WATonomous/interfacing-mono/DBW-boards/readMe.md

# DBW Boards
- This folder contaisn schematics, pcb layouts, as well as component lists + where to order for the DBW boards for Watonomous's VP division.
- There are 4 boards to be assembled/fabricated off of these. 
##Boards
- Control (Brake)
- Can Gateway
- 2 Sensor boards, one for throttle and one for steering

### Each board is a Kicad project, simply download this repo and open them in Kicad.
