WATonomous/interfacing-mono/oscc-joystick-commander/oscc/hardware/3d_models/brake_enclosure/brake_assembly.SLDASM

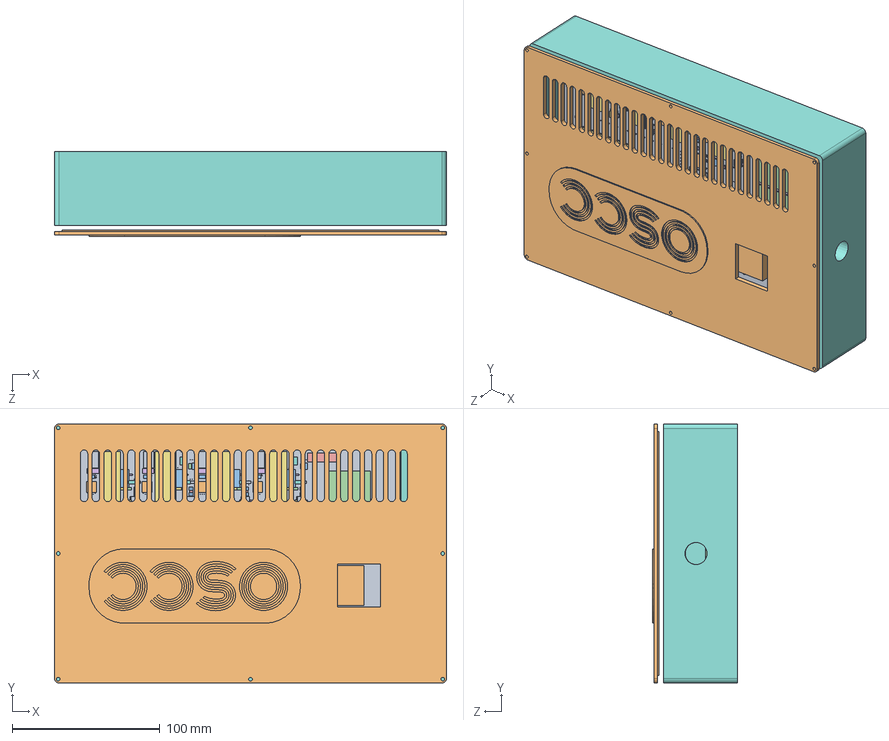
[picture p2: CAD file, 2024-09-14]
oscc-joystick-commander/oscc/hardware/3d_models/brake_enclosure/brake_assembly.SLDASM
265.0 x 175.0 x 57.4 mm
polysync_braking
1X08_1X08 x 5
C1206_1U x 12
C0805_0_1U x 12
C0402_100P x 8
C0402__1U x 18
CP1206_33U
C0402_22P x 2
PHOENIX_2_45_CON23_5MM x 9
PHOENIX_3_45_CON3 x 2
PHOENIX_2_10_16MM_CON210_16MM
1932575_CON1 x 2
PHOENIX_5_45_CON5
SMA_DIODES_SMA x 8
SOD123_DIODES_SOD123 x 8
LED0603_D17_LED0603
LED0603_D18_LED0603
LED0603_D19_LED0603
LED0603_D20_LED0603
LED0603_D21_LED0603
FUSE_ATO_20A x 2
FUSE_ATO_40A
HEATSINKTO263_HEATSINKTO263 x 8
1X10_1X10
JP1_JP2_JP1
SRP7050_2_2U x 8
TO2633_NFETTO263 x 8
SOT233_Q9_SOT233
EMT3F_RE1C002UN
R0402_10K x 9
R0805_100 x 8
R1206__02 x 8
R0805_0 x 8
R0402_100K x 24
R0402_1K x 45
R0402__3
R0402_120
R0402_47K
R0402_0 x 5
R0402_DNP x 5
KEMET_EE2_RELAY_DPDT
VCF4_RELAY_RELAY_BOM
VCF4SOCKET_RELAY_VF4
TP_4545_TP1_TP_4545
TP_4545_TP2_TP_4545
TP_4545_TP3_TP_4545
POLYSYNC_BRAKE_TOP_U_8_POLYSYNC_BRAKE_TOP
SOIC8_UCC27524 x 4
SOT235_OPA170 x 8
TO263_TL750M
SOIC86_0_MCP2551
SOIC18_MCP2515
HC49UP_16MHZ
2X18_2X18
ArduinoMega
brake_housing
brake_cable_clamp
brake_house_lid
