WATonomous/interfacing-mono/oscc-joystick-commander/oscc/hardware/3d_models/dash_enclosure/STC_assembly.SLDASM

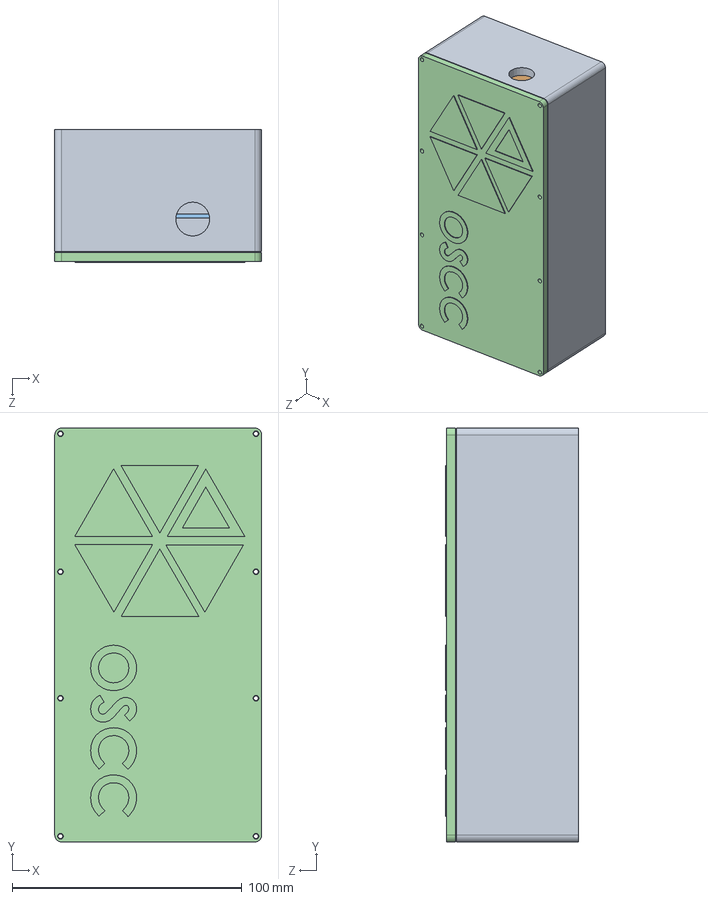
[picture p3: CAD file, 2024-09-14]
oscc-joystick-commander/oscc/hardware/3d_models/dash_enclosure/STC_assembly.SLDASM
90.2 x 180.0 x 57.9 mm
STC_housing
ArduinoUnoMockup x 3
CANShieldMockup x 2
STC_lid
