WATonomous/interfacing-mono/oscc-joystick-commander/oscc/hardware/3d_models/kia_soul/actuator_bracket_assembly.SLDASM

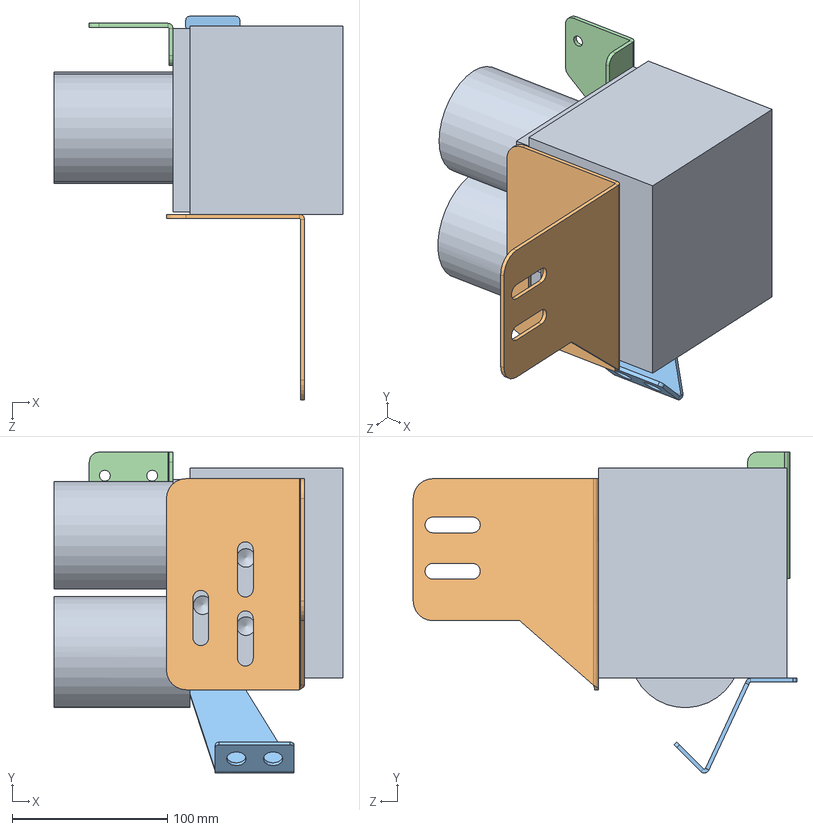
[picture p4: CAD file, 2024-09-14]
oscc-joystick-commander/oscc/hardware/3d_models/kia_soul/actuator_bracket_assembly.SLDASM
185.7 x 206.6 x 246.8 mm
actuator_mockup
side_bracket
bottom_bracket
reservoir_bracket
