WATonomous/interfacing-mono/oscc-joystick-commander/oscc/hardware/3d_models/brake_enclosure/actuator_control_board_enclosure_assembly.SLDASM

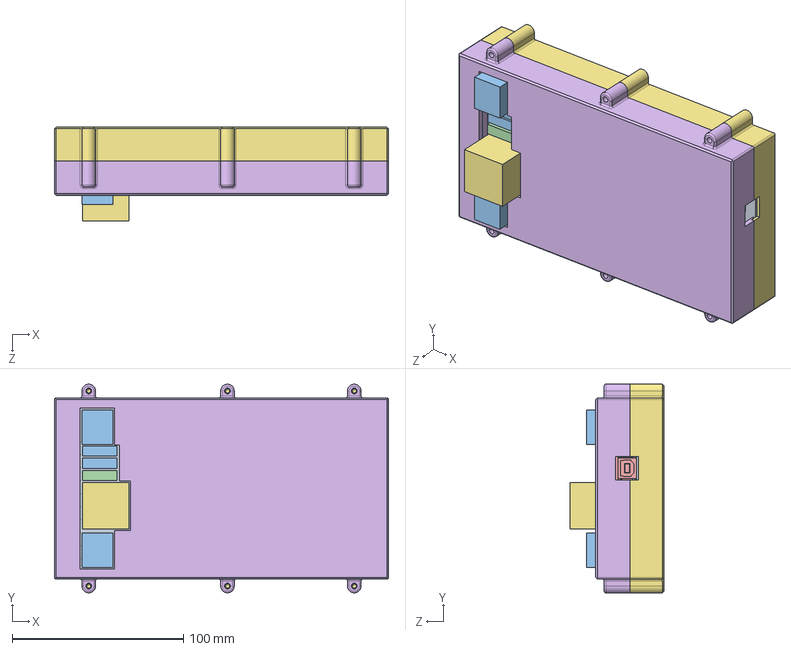
[picture p5: CAD file, 2024-09-14]
oscc-joystick-commander/oscc/hardware/3d_models/brake_enclosure/actuator_control_board_enclosure_assembly.SLDASM
195.2 x 122.0 x 55.0 mm
actuator_control_board_100
1X08_1X08 x 5
C1206_1U x 12
C0805_0_1U x 12
C0402_100P x 8
C0402__1U x 18
CP1206_33U
C0402_22P x 2
PHOENIX_2_45_CON23_5MM x 10
PHOENIX_3_45_CON3 x 2
PHOENIX_2_10_16MM_CON210_16MM x 2
PHOENIX_5_45_CON5
SMA_DIODES_SMA x 8
SOD123_DIODES_SOD123 x 8
LED0603_D17_LED0603
LED0603_GREEN x 2
LED0603_RED
LED0603_BLUE
FUSE_ATO_20A x 2
FUSE_ATO_40A
1X10_1X10
JP1_JP2_JP1
SRP7050_2_2U x 8
SON8DQJ_NFETTO263NEXFET x 8
SOT233_Q9_SOT233
EMT3F_RE1C002UN
R0402_10K x 9
R0805_100 x 8
R1206__02 x 8
R0805_0 x 8
R0402_100K x 24
R0402_1K x 45
R0402__3
R0402_120
R0402_47K
R0402_0 x 5
R0402_DNP x 5
KEMET_EE2_RELAY_DPDT
VCF4_RELAY_RELAY_BOM
HEATSINK_2X_75_U_3_HEATSINK_2X_75
HEATSINK_2X_75_U_7_HEATSINK_2X_75
HEATSINK_2X_75_U_9_HEATSINK_2X_75
HEATSINK_2X_75_U_10_HEATSINK_2X_75
OSCC_LOGO_U_11_OSCC_LOGO
POLYSYNC_U_13_POLYSYNC
SOIC8_UCC27524 x 4
SOT235_OPA170 x 8
TO263_TL750M
SOIC86_0_MCP2551
SOIC18_MCP2515
HC49UP_16MHZ
2X18_2X18
ArduinoMega
actuator_control_board_enclosure_top
actuator_control_board_enclosure_bottom
