WATonomous/interfacing-mono/oscc-joystick-commander/oscc/hardware/3d_models/dash_enclosure/STC_housing.sldprt

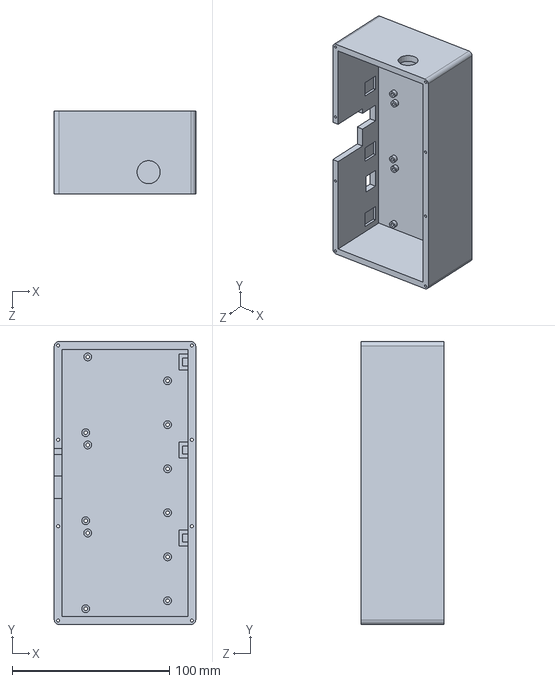
[picture p6: CAD file, 2024-09-14]
oscc-joystick-commander/oscc/hardware/3d_models/dash_enclosure/STC_housing.sldprt
90.0 x 180.0 x 53.0 mm
