WATonomous/interfacing-mono/oscc-joystick-commander/oscc/hardware/3d_models/estop_cupholder/EStopHousing.SLDPRT

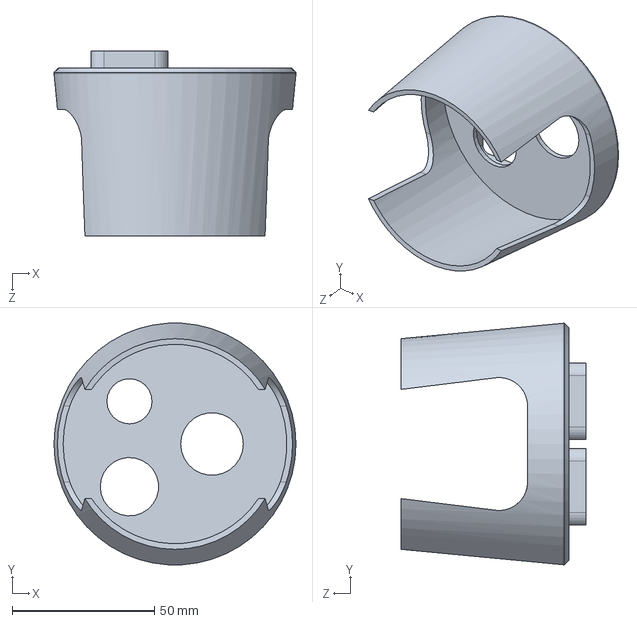
[picture p7: CAD file, 2024-09-14]
oscc-joystick-commander/oscc/hardware/3d_models/estop_cupholder/EStopHousing.SLDPRT
85.0 x 84.8 x 65.0 mm
