WATonomous/interfacing-mono/oscc-joystick-commander/oscc/hardware/3d_models/kia_soul/side_bracket.SLDPRT

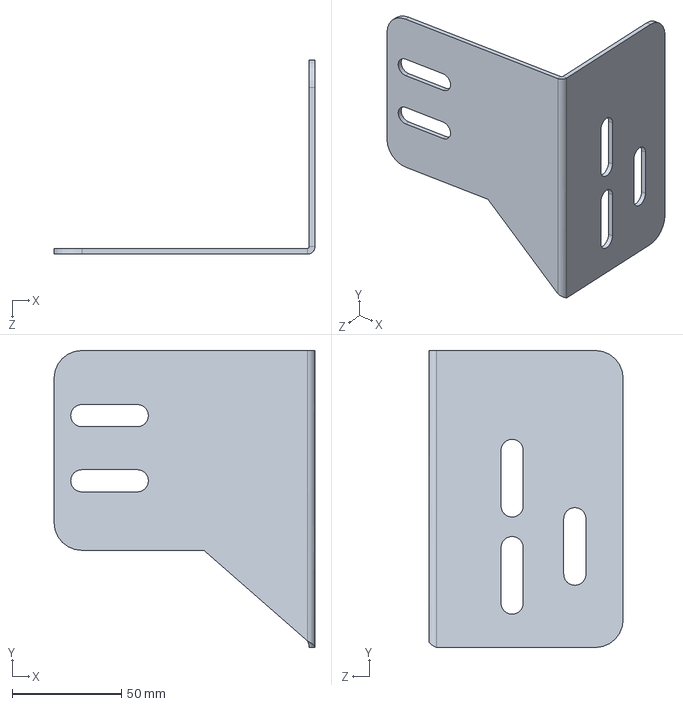
[picture p8: CAD file, 2024-09-14]
oscc-joystick-commander/oscc/hardware/3d_models/kia_soul/side_bracket.SLDPRT
119.4 x 135.9 x 88.9 mm
