WATonomous/interfacing-mono/oscc-joystick-commander/oscc/hardware/3d_models/kia_soul/reservoir_bracket.SLDPRT

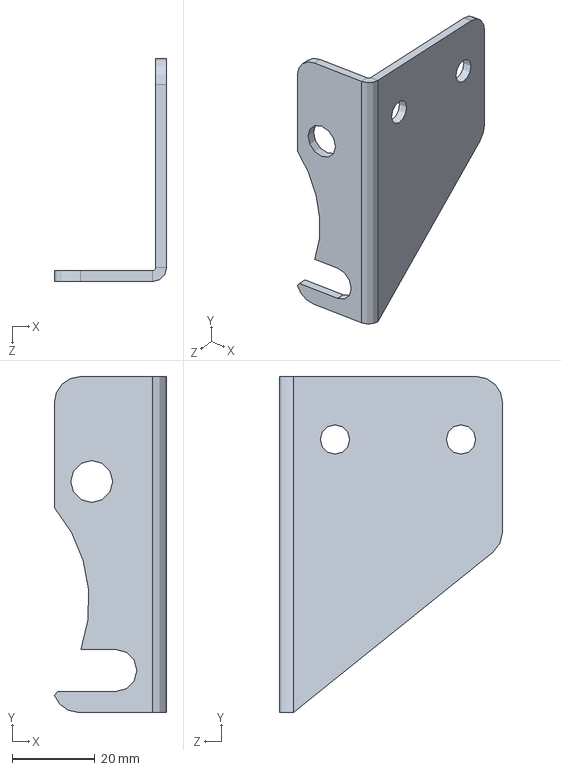
[picture p9: CAD file, 2024-09-14]
oscc-joystick-commander/oscc/hardware/3d_models/kia_soul/reservoir_bracket.SLDPRT
27.2 x 81.3 x 54.0 mm
