WATonomous/interfacing-mono/oscc-joystick-commander/oscc/hardware/3d_models/brake_enclosure/brake_cable_clamp.SLDPRT

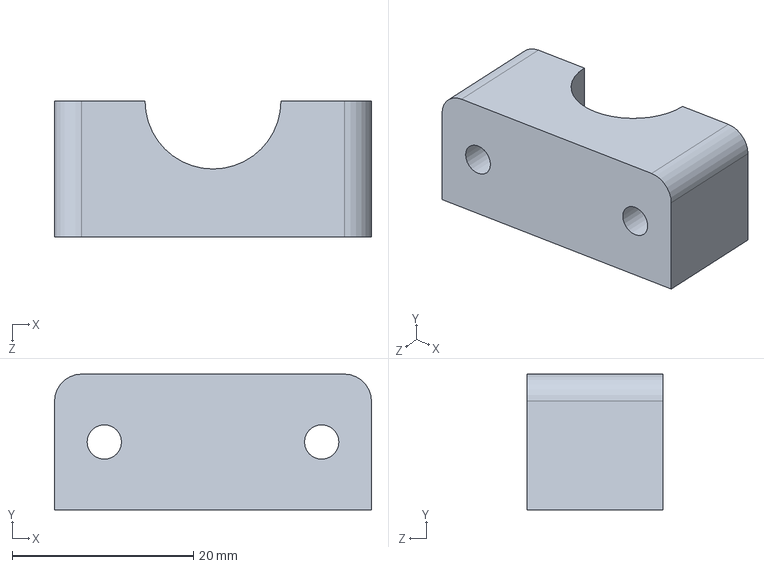
[picture p10: CAD file, 2024-09-14]
oscc-joystick-commander/oscc/hardware/3d_models/brake_enclosure/brake_cable_clamp.SLDPRT
35.0 x 15.0 x 15.0 mm
