WATonomous/interfacing-mono/oscc-joystick-commander/oscc/hardware/3d_models/dash_enclosure/ArduinoUnoMockup.SLDPRT

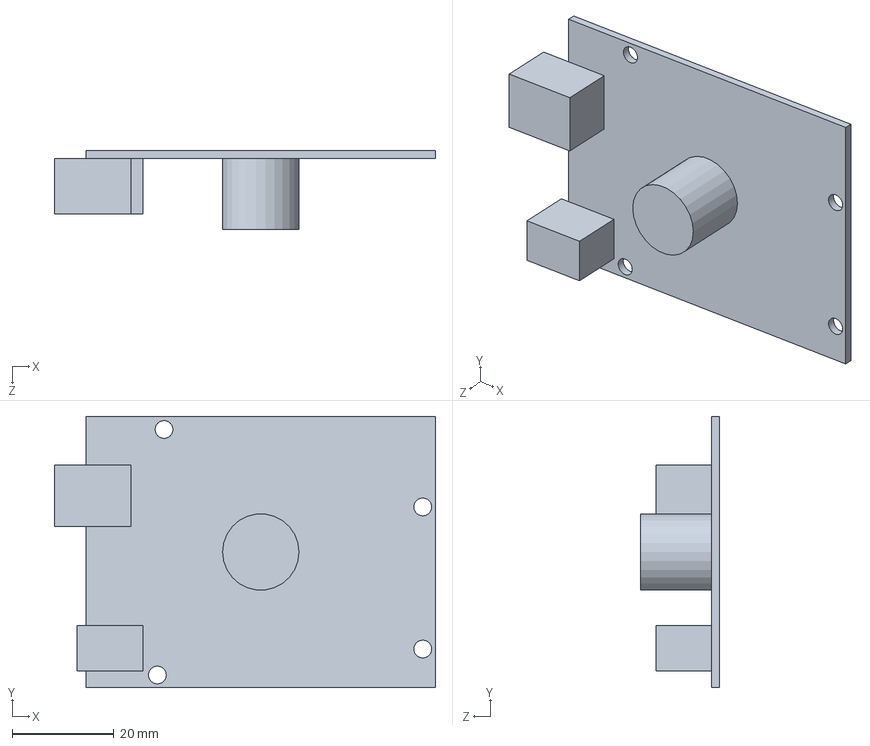
[picture p11: CAD file, 2024-09-14]
oscc-joystick-commander/oscc/hardware/3d_models/dash_enclosure/ArduinoUnoMockup.SLDPRT
74.8 x 53.3 x 15.6 mm
