WATonomous/interfacing-mono/oscc-joystick-commander/oscc/hardware/3d_models/kia_soul/actuator_mockup.SLDPRT

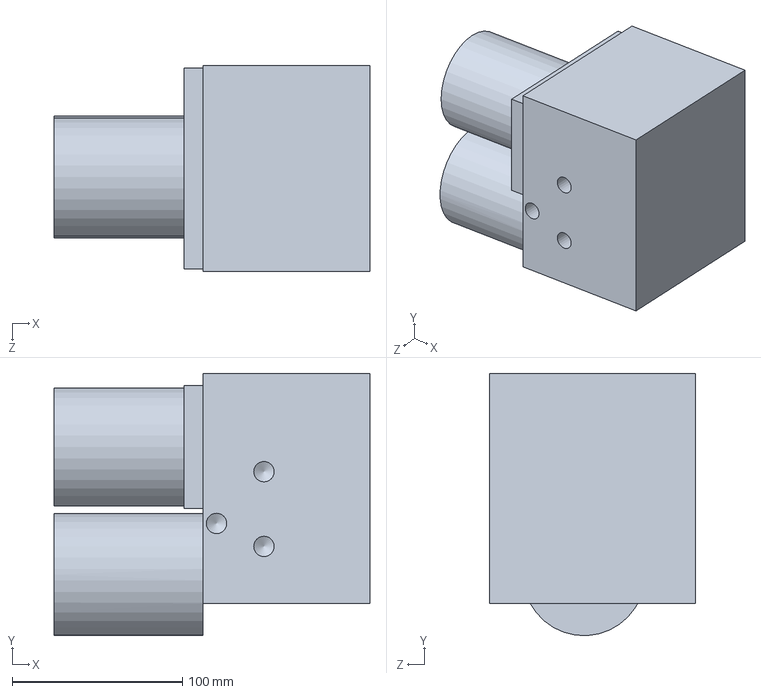
[picture p12: CAD file, 2024-09-14]
oscc-joystick-commander/oscc/hardware/3d_models/kia_soul/actuator_mockup.SLDPRT
185.7 x 154.1 x 121.2 mm
