WATonomous/interfacing-mono/oscc-joystick-commander/oscc/hardware/3d_models/brake_enclosure/brake_house_lid.SLDPRT

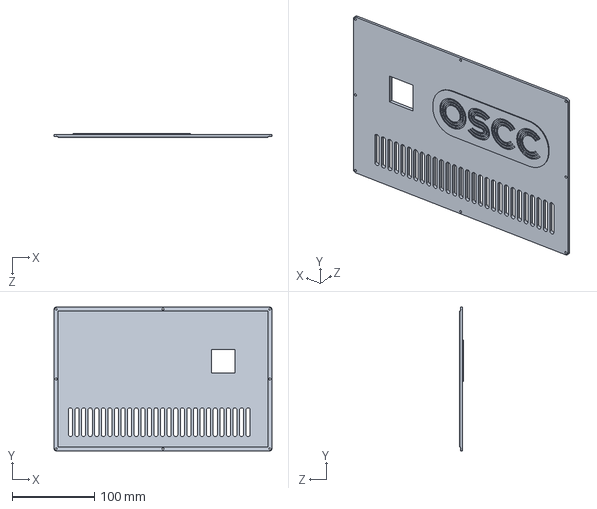
[picture p13: CAD file, 2024-09-14]
oscc-joystick-commander/oscc/hardware/3d_models/brake_enclosure/brake_house_lid.SLDPRT
265.0 x 175.0 x 4.50 mm
