WATonomous/interfacing-mono/oscc-joystick-commander/oscc/hardware/3d_models/brake_enclosure/actuator_control_board_enclosure_top.SLDPRT

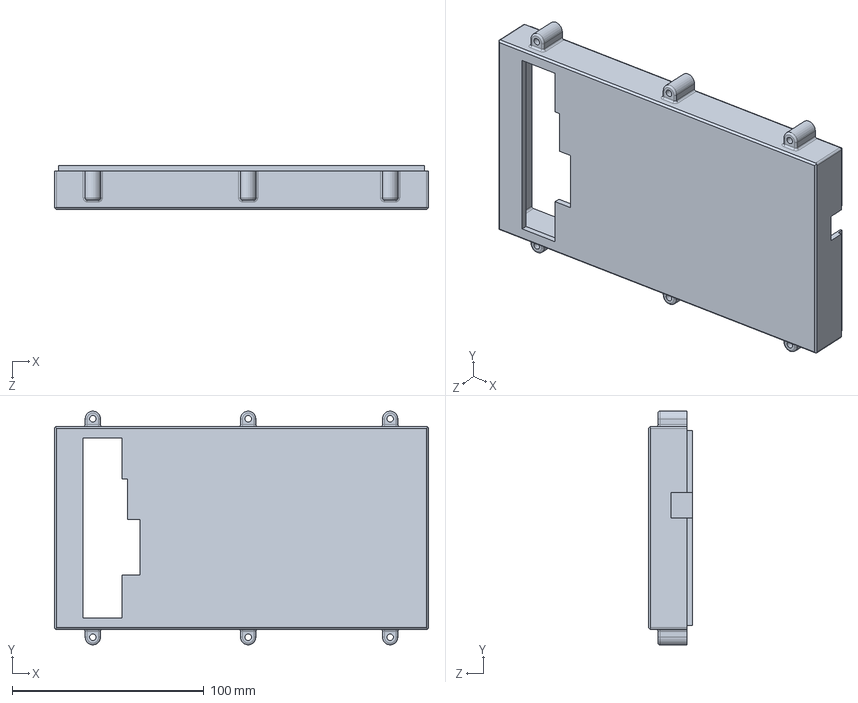
[picture p15: CAD file, 2024-09-14]
oscc-joystick-commander/oscc/hardware/3d_models/brake_enclosure/actuator_control_board_enclosure_top.SLDPRT
195.2 x 122.0 x 23.0 mm
