WATonomous/interfacing-mono/oscc-joystick-commander/oscc/hardware/3d_models/dash_enclosure/STC_lid.SLDPRT

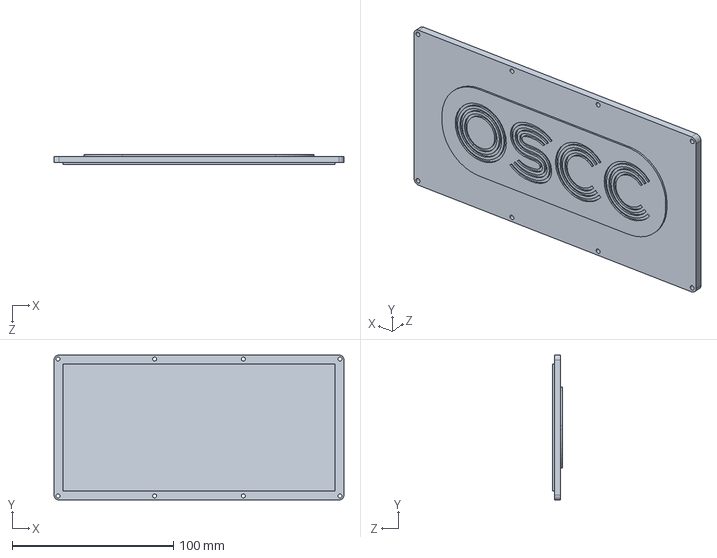
[picture p16: CAD file, 2024-09-14]
oscc-joystick-commander/oscc/hardware/3d_models/dash_enclosure/STC_lid.SLDPRT
180.0 x 90.0 x 6.00 mm
