WATonomous/interfacing-mono/oscc-joystick-commander/oscc/hardware/3d_models/kia_soul/bottom_bracket.SLDPRT

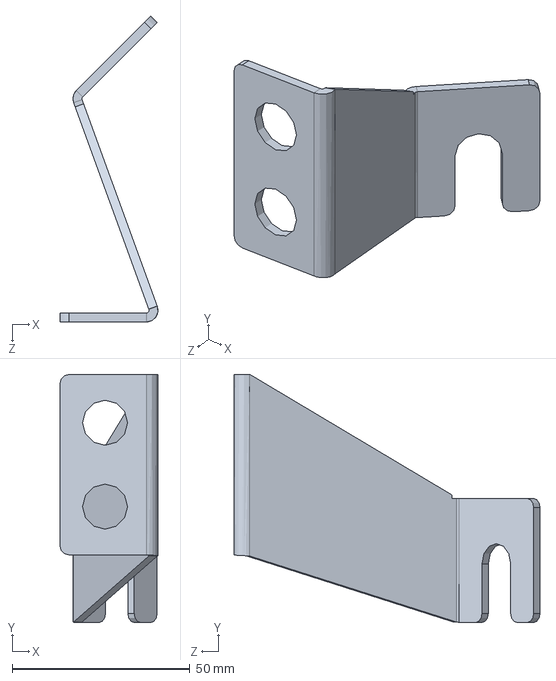
[picture p17: CAD file, 2024-09-14]
oscc-joystick-commander/oscc/hardware/3d_models/kia_soul/bottom_bracket.SLDPRT
27.6 x 69.8 x 86.2 mm
