WATonomous/interfacing-mono/oscc-joystick-commander/oscc/hardware/3d_models/brake_enclosure/brake_housing.SLDPRT

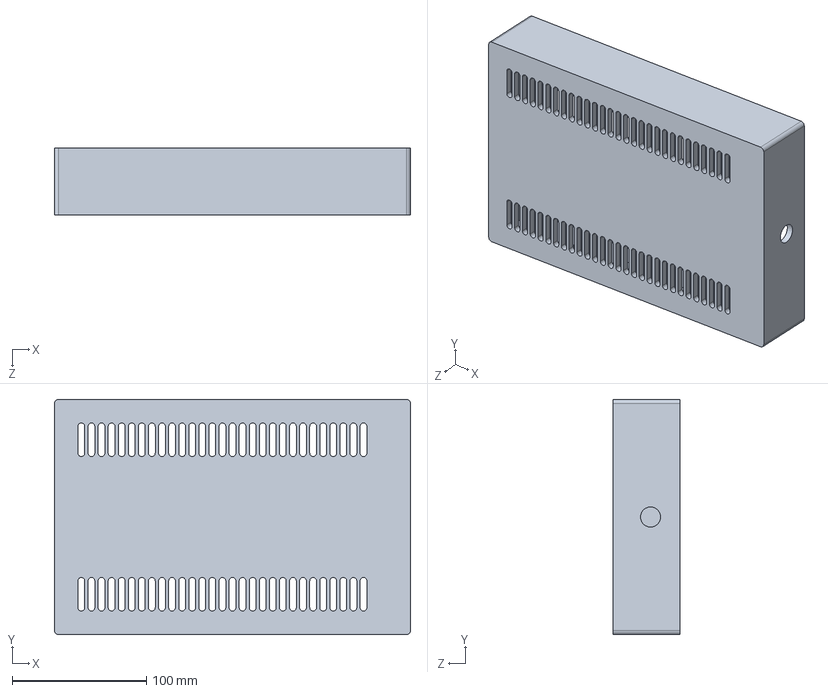
[picture p18: CAD file, 2024-09-14]
oscc-joystick-commander/oscc/hardware/3d_models/brake_enclosure/brake_housing.SLDPRT
265.0 x 175.0 x 50.0 mm
