WATonomous/interfacing-mono/(list of files, cad)

Other CAD files:
oscc-joystick-commander/oscc/hardware/3d_models/brake_enclosure/actuator_control_board_enclosure_bottom.STL
oscc-joystick-commander/oscc/hardware/3d_models/brake_enclosure/actuator_control_board_enclosure_top.STL
oscc-joystick-commander/oscc/hardware/3d_models/brake_enclosure/brake_cable_clamp.STL
oscc-joystick-commander/oscc/hardware/3d_models/brake_enclosure/brake_house_lid.STL
oscc-joystick-commander/oscc/hardware/3d_models/brake_enclosure/brake_housing.STL
oscc-joystick-commander/oscc/hardware/3d_models/dash_enclosure/STC_housing.STL
oscc-joystick-commander/oscc/hardware/3d_models/dash_enclosure/STC_lid.STL
oscc-joystick-commander/oscc/hardware/3d_models/estop_cupholder/EStopHousing.STL
oscc-joystick-commander/oscc/hardware/3d_models/kia_soul/bottom_bracket.SLDDRW
oscc-joystick-commander/oscc/hardware/3d_models/kia_soul/reservoir_bracket.SLDDRW
oscc-joystick-commander/oscc/hardware/3d_models/kia_soul/side_bracket.SLDDRW
