WATonomous/interfacing-mono/oscc-joystick-commander/oscc/hardware/3d_models/kia_soul/bottom_bracket.PDF

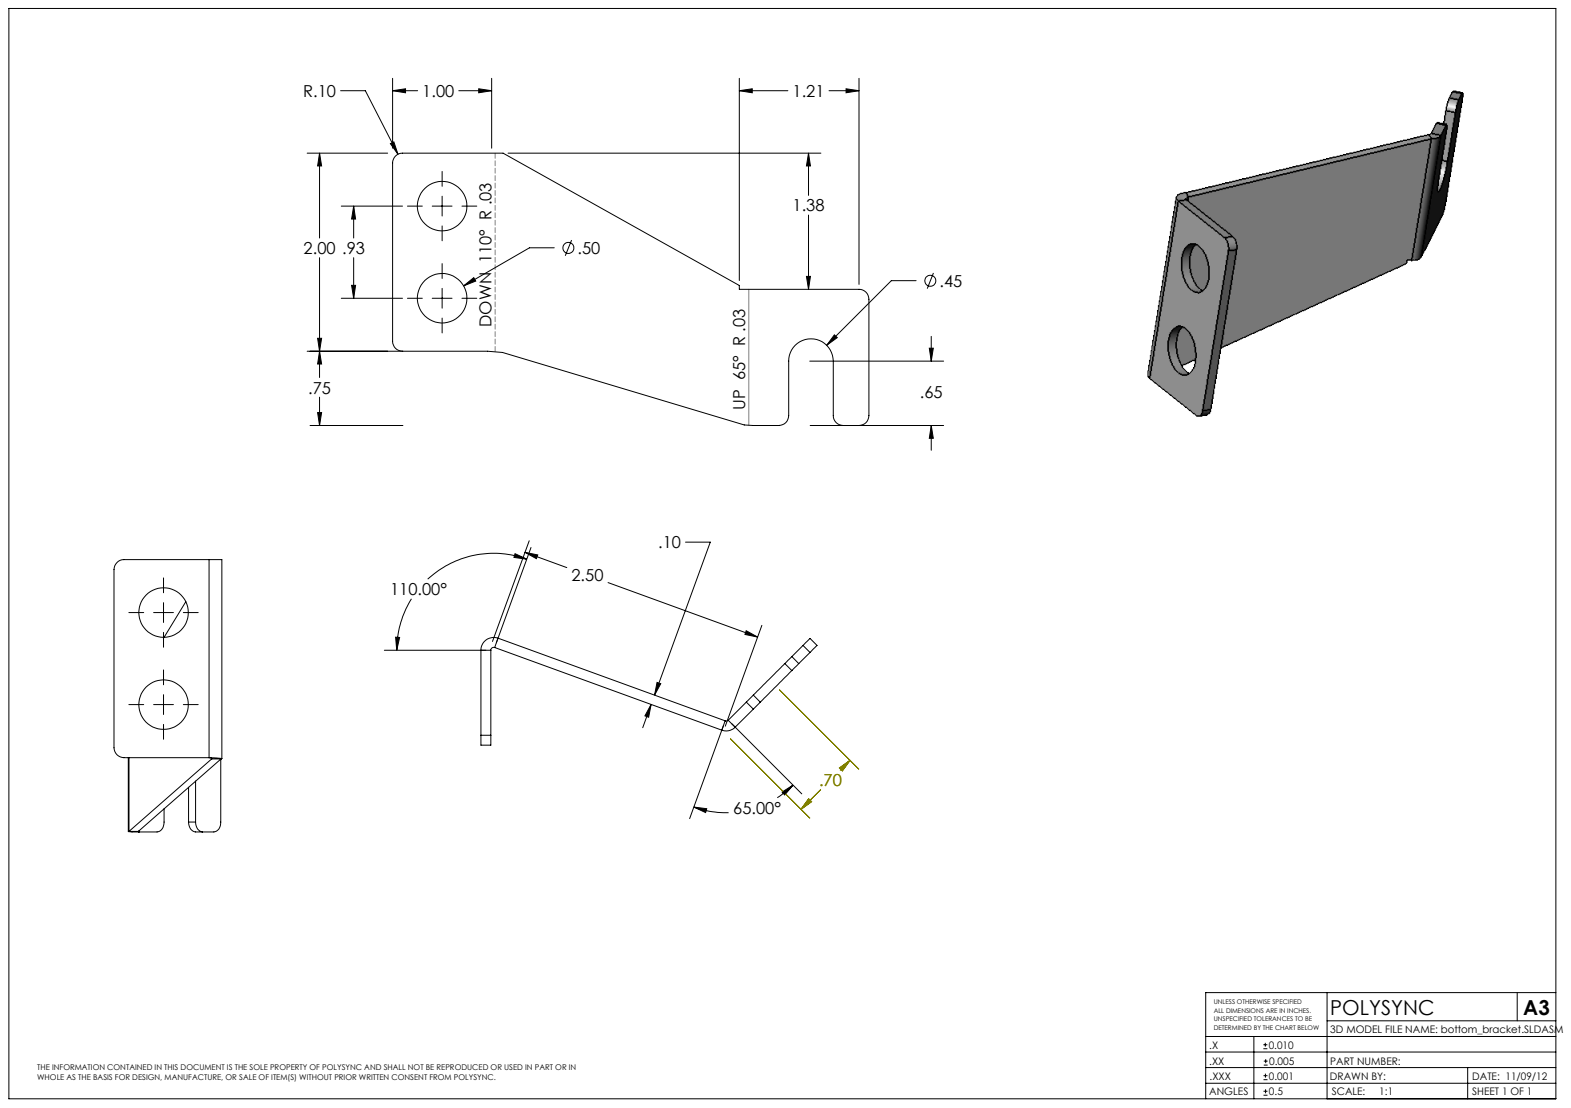
[picture p20: page 1]
DOWN 110° R .03

UNLESS OTHERWISE SPECIFIED
ALL DIMENSIONS ARE IN INCHES.
UNSPECIFIED TOLERANCES TO BE
DETERMINED BY THE CHART BELOW

3D MODEL FILE NAME: bottom_bracket.SLDASM

.X | 0.010
.XX | 0.005 | PART NUMBER:
.XXX | 0.001 | DRAWN BY: | DATE: 11/09/12
ANGLES | 0.5 | SCALE: 1:1 | SHEET 1 OF 1

THE INFORMATION CONTAINED IN THIS DOCUMENT IS THE SOLE PROPERTY OF POLYSYNC AND SHALL NOT BE REPRODUCED OR USED IN PART OR IN
WHOLE AS THE BASIS FOR DESIGN, MANUFACTURE, OR SALE OF ITEM(S) WITHOUT PRIOR WRITTEN CONSENT FROM POLYSYNC.
