WATonomous/interfacing-mono/DBW-boards/sensor_interface/sensor_interface_1.1.0.kicad_pcb

## KiCad design DBW-boards/sensor_interface/sensor_interface_1.1.0.kicad_pcb (2024-09-16)

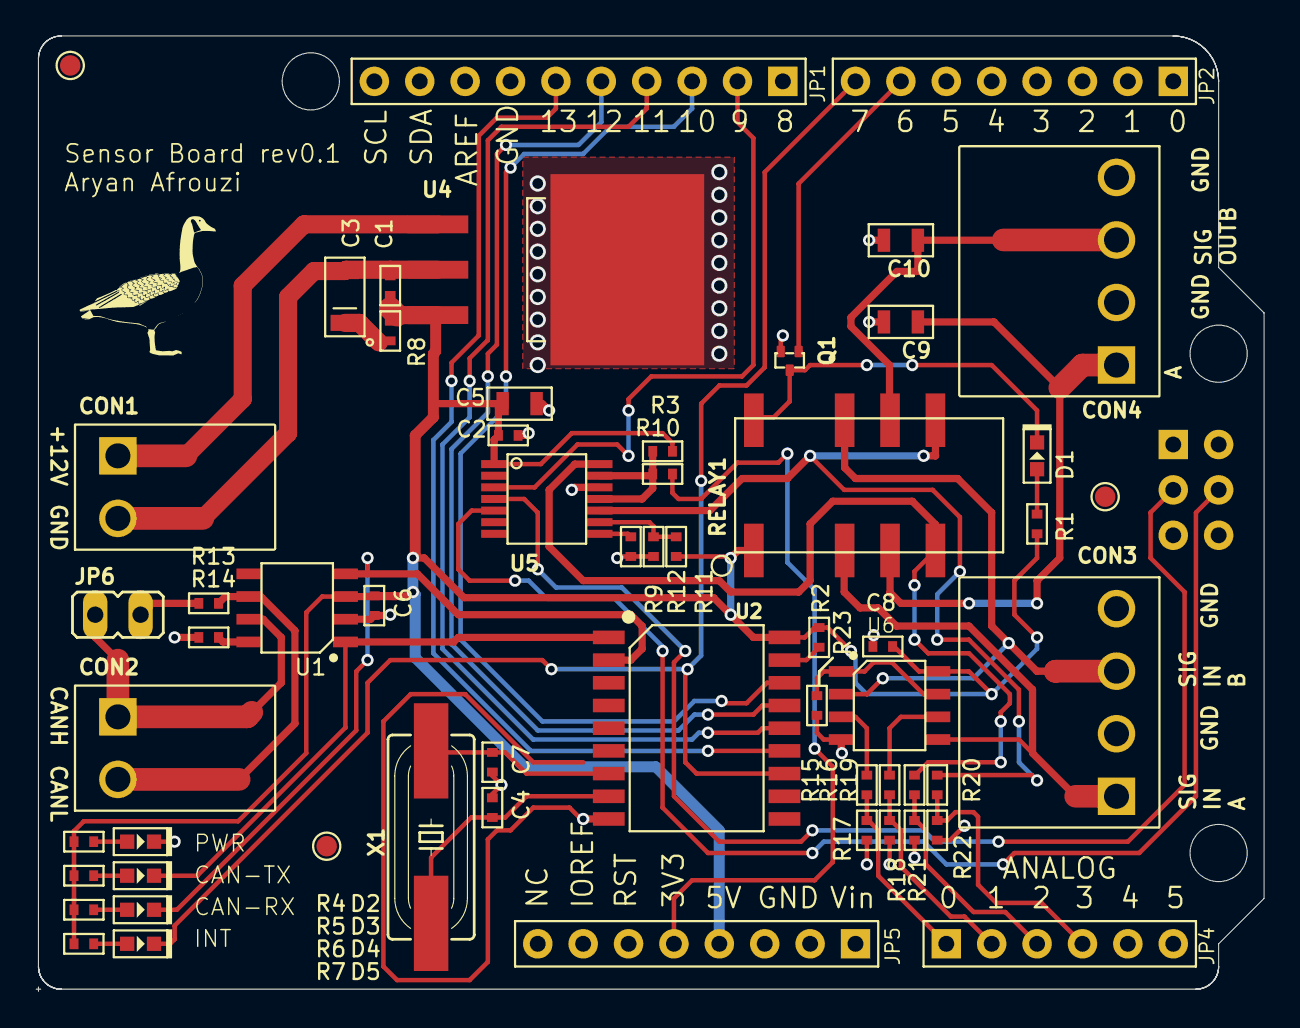
[picture p21: board sensor_interface_1.1.0.kicad_pcb from above]

Board: 2 copper layers, 68.6 x 53.3 mm, 60 parts (0 on the bottom side), 45 nets.

Parts:
C1, C2, C6, C8: .1u; C0402
C3: 33u; CP1206
C4, C7: 22p; C0402
C5, C9, C10: 10u; C0805
CON1, CON2: CON23.5MM; PHOENIX_2_45
CON3, CON4: PHOENIX_4_45
D1, D4: Red; LED0603
D2, D3: Green; LED0603
D5: Blue; LED0603
JP1: ARDUINO_JP1
JP2: ARDUINO_JP2
JP3: ARDUINO_JP3
JP4: ARDUINO_JP4
JP5: ARDUINO_JP5
JP6: JP1
Q1: RE1C002UN; EMT3F
R1, R4, R5, R6, R7: 1k; R0402
R2, R9, R11, R17, R18, R23: 10k; R0402
R3, R15, R16, R19, R20: 0; R0402
R8: .3; R0402
R10, R12, R21, R22: DNP; R0402
R13: 120; R0402
R14: 47k; R0402
RELAY1: RELAY_DPDT; KEMET_EE2
TP1, TP2, TP3: TP_4545
U1: MCP2551; SOIC8-6.0
U2: MCP2515; SOIC18
U4: TL750M; TO-263
U5: MCP4922T; TSSOP-14
U6: SN74CBT3306CD; SOIC-8
U$1: POLYSYNC_STEERING_BOT
X1: 16MHz; HC49UP

Connections:
+3V3: JP5.22, R10.P$1
+5V: C1.P$1, C2.P$1, C5.P$1, C6.P$1, C8.P$1, JP5.23, R1.P$2, R2.P$1, R3.P$1, R4.P$2, R5.P$2, R6.P$2, R7.P$2, R8.P$1, R11.P$1, RELAY1.P$1, U1.3, U2.18, U4.P$3, U5.P$1, U6.8
ADC0: JP4.27, R15.P$2, R17.P$1
ADC1: JP4.28, R16.P$2, R18.P$1
ADC2: JP4.29, R19.P$2, R21.P$1
ADC3: JP4.30, R20.P$2, R22.P$1
CANH: CON2.P$1, JP6.1, U1.7
CANL: CON2.P$2, R13.P$1, U1.6
CS_A: JP1.10, U5.P$3
CS_B: JP1.11, U2.16
GND: C1.P$2, C2.P$2, C3.P$2, C4.P$1, C5.P$2, C6.P$2, C7.P$1, C8.P$2, C9.P$2, C10.P$2, CON1.P$2, CON3.P$2, CON3.P$4, CON4.P$2, CON4.P$4, D2.CATHODE, JP1.15, JP3.36, JP5.24, JP5.25, Q1.P$2, R9.P$2, R12.P$2, R14.P$2, R17.P$2, R18.P$2, R21.P$2, R22.P$2, R23.P$2, U1.2, U2.9, U4.P$2, U4.P$4, U5.P$12, U6.4
INT: D5.CATHODE, JP2.8, U2.12
LDAC: R9.P$1, U5.P$8
MISO_B: JP1.13, U2.15
MOSI_A: JP3.37, U5.P$5
MOSI_B: JP1.12, U2.14
unnamed: D3.ANODE, R5.P$1
unnamed: JP6.2, R13.P$2
unnamed: D1.CATHODE, Q1.P$3, RELAY1.P$12
unnamed: C3.P$1, R8.P$2
unnamed: D4.ANODE, R6.P$1
unnamed: D2.ANODE, R4.P$1
unnamed: R3.P$2, R10.P$2, U5.P$11, U5.P$13
unnamed: D5.ANODE, R7.P$1
unnamed: R14.P$1, U1.8
unnamed: D1.ANODE, R1.P$1
unnamed: R23.P$1, U6.1, U6.7
unnamed: R16.P$1, U6.6
unnamed: R15.P$1, U6.3
unnamed: C7.P$2, U2.7, X1.2
unnamed: C4.P$2, U2.8, X1.1
RST_N: R2.P$2, U2.17
RX_CAN: D4.CATHODE, U1.4, U2.2
SCK_A: JP3.34, U5.P$4
SCK_B: JP1.14, U2.13
SHDN: R11.P$2, R12.P$1, U5.P$9
SIGNAL_INPUT_A: CON3.P$1, RELAY1.P$3, U6.5
SIGNAL_INPUT_B: CON3.P$3, RELAY1.P$10, U6.2
SIGNAL_OUTPUT_A: C9.P$1, CON4.P$1, RELAY1.P$4
SIGNAL_OUTPUT_B: C10.P$1, CON4.P$3, RELAY1.P$9
SPOOF_EN: JP2.7, Q1.P$1
SPOOF_SIGNAL_A: R19.P$1, RELAY1.P$5, U5.P$14
SPOOF_SIGNAL_B: R20.P$1, RELAY1.P$8, U5.P$10
TX_CAN: D3.CATHODE, U1.1, U2.1
V+: CON1.P$1, U4.P$1
