WATonomous/interfacing-mono/DBW-boards/gateway/gateway_r0.kicad_pcb

## KiCad design DBW-boards/gateway/gateway_r0.kicad_pcb (2024-09-16)

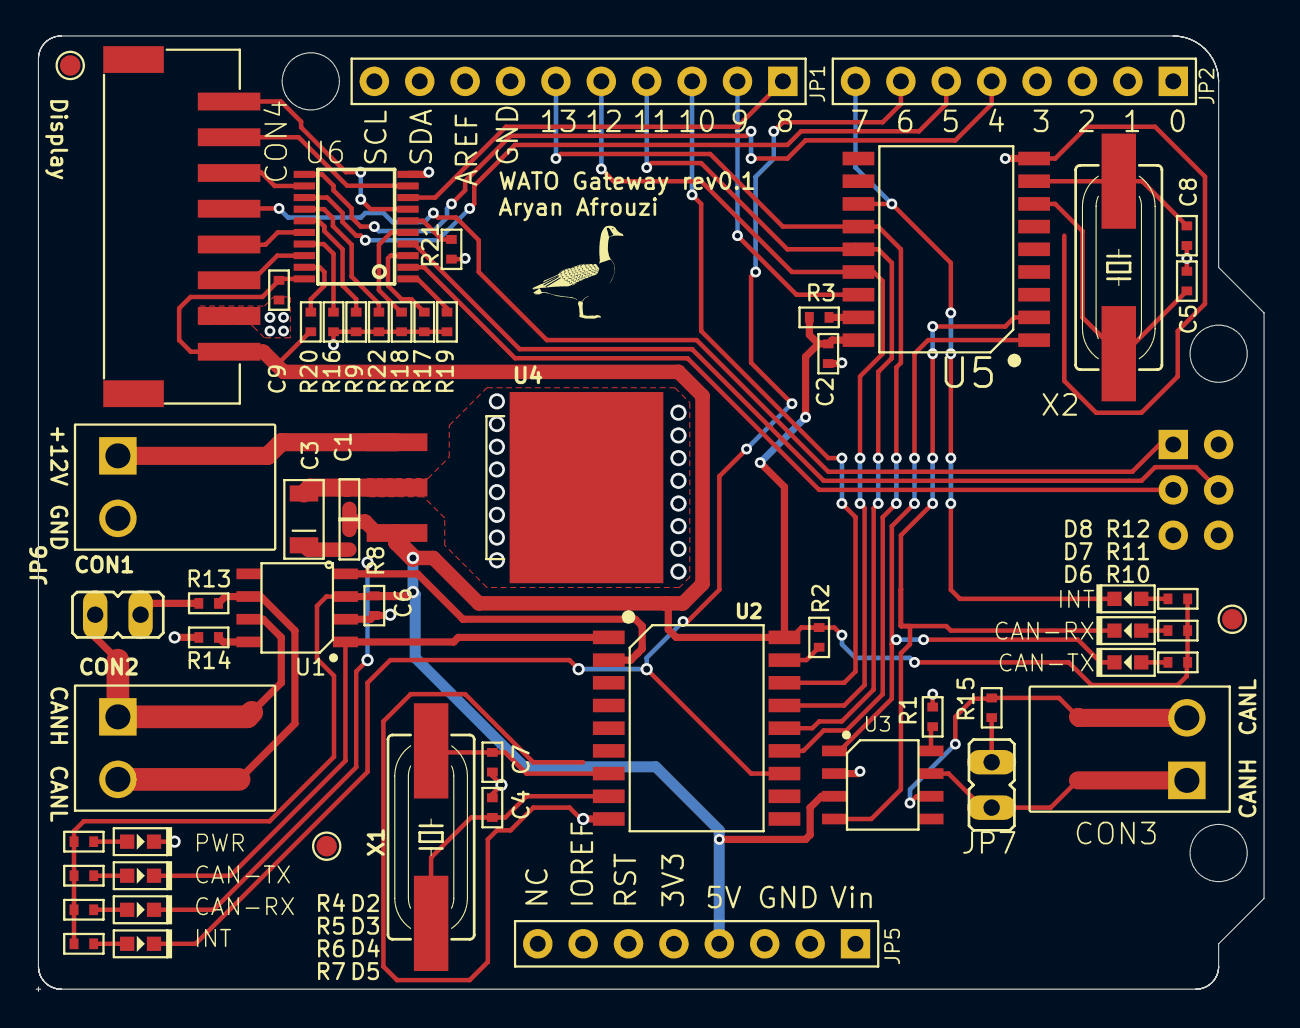
[picture p22: board gateway_r0.kicad_pcb from above]

Board: 2 copper layers, 68.6 x 53.3 mm, 59 parts (0 on the bottom side), 55 nets.

Parts:
C1, C2, C6, C9: .1u; C0402
C3: 33u; CP1206
C4, C5, C7, C8: 22p; C0402
CON1, CON2, CON3: CON23.5MM; PHOENIX_2_45
CON4: CON8; PH-8-SM
D2, D3, D6: Green; LED0603
D4, D7: Red; LED0603
D5, D8: Blue; LED0603
JP1: ARDUINO_JP1
JP2: ARDUINO_JP2
JP3: ARDUINO_JP3
JP5: ARDUINO_JP5
JP6, JP7: JP1
R1, R14: 47k; R0402
R2, R3, R9, R16, R17, R18, R19, R20, R21, R22: 10k; R0402
R4, R5, R6, R7, R10, R11, R12: 1k; R0402
R8: .3; R0402
R13, R15: 120; R0402
TP1, TP2, TP3: TP_4545
U1, U3: MCP2551; SOIC8-6.0
U2, U5: MCP2515; SOIC18
U4: TL750M; TO-263
U6: 74241PW; PW_R-PDSO-G20
X1, X2: 16MHz; HC49UP

Connections:
164_CS: JP2.5, U6.11
165_~CS: JP2.6, U6.13
+5V: C1.P$1, C2.P$1, C6.P$1, C9.P$1, CON4.P$1, JP5.23, R2.P$1, R3.P$1, R4.P$2, R5.P$2, R6.P$2, R7.P$2, R8.P$1, R10.P$2, R11.P$2, R12.P$2, R20.P$1, U1.3, U2.18, U3.3, U4.P$3, U5.18, U6.20
CANH_0: CON3.P$1, JP7.1, U3.7
CANH_1: CON2.P$1, JP6.1, U1.7
CANL_0: CON3.P$2, R15.P$1, U3.6
CANL_1: CON2.P$2, R13.P$1, U1.6
CS_0: JP1.10, U5.16
CS_1: JP1.11, U2.16
GND: C1.P$2, C2.P$2, C3.P$2, C4.P$1, C5.P$1, C6.P$2, C7.P$1, C8.P$1, C9.P$2, CON1.P$2, CON4.P$2, D2.CATHODE, JP1.15, JP3.36, JP5.24, JP5.25, R1.P$2, R9.P$2, R14.P$2, R16.P$2, R17.P$2, R18.P$2, R19.P$2, R21.P$2, R22.P$2, U1.2, U2.9, U3.2, U4.P$2, U4.P$4, U5.9, U6.10
INT_0: D8.CATHODE, JP2.8, U5.12
INT_1: D5.CATHODE, JP2.7, U2.12
LCD_~CS: JP1.9, U6.8
MISO_A: CON4.P$5, JP3.33
MISO_B: JP1.13, U2.15, U5.15
MOSI_A: JP3.37, U6.4
MOSI_B: JP1.12, U2.14, U5.14
unnamed: D3.ANODE, R5.P$1
unnamed: JP6.2, R13.P$2
unnamed: C5.P$2, U5.7, X2.2
unnamed: C3.P$1, R8.P$2
unnamed: D4.ANODE, R6.P$1
unnamed: D2.ANODE, R4.P$1
unnamed: C8.P$2, U5.8, X2.1
unnamed: D5.ANODE, R7.P$1
unnamed: R14.P$1, U1.8
unnamed: R1.P$1, U3.8
unnamed: CON4.P$3, U6.18
unnamed: D6.ANODE, R10.P$1
unnamed: D7.ANODE, R11.P$1
unnamed: D8.ANODE, R12.P$1
unnamed: JP7.2, R15.P$2
unnamed: C7.P$2, U2.7, X1.2
unnamed: C4.P$2, U2.8, X1.1
unnamed: CON4.P$4, U6.16
unnamed: R21.P$1, U6.6
unnamed: CON4.P$6, U6.12
unnamed: CON4.P$7, U6.9
unnamed: CON4.P$8, U6.7
unnamed: R9.P$1, U6.15
unnamed: R16.P$1, U6.17
unnamed: R17.P$1, U6.3
unnamed: R18.P$1, U6.5
unnamed: R19.P$1, U6.1
unnamed: R20.P$2, U6.19
unnamed: R22.P$1, U6.14
RST_N: R2.P$2, U2.17
RST_N1: R3.P$2, U5.17
RX_CAN_0: D7.CATHODE, U3.4, U5.2
RX_CAN_1: D4.CATHODE, U1.4, U2.2
SCK_A: JP3.34, U6.2
SCK_B: JP1.14, U2.13, U5.13
TX_CAN_0: D6.CATHODE, U3.1, U5.1
TX_CAN_1: D3.CATHODE, U1.1, U2.1
V+: CON1.P$1, U4.P$1
