WATonomous/interfacing-mono/DBW-boards/actuator_control/actuator_control_1.2.0.brd

## EAGLE design DBW-boards/actuator_control/actuator_control_1.2.0.brd (2024-09-14)

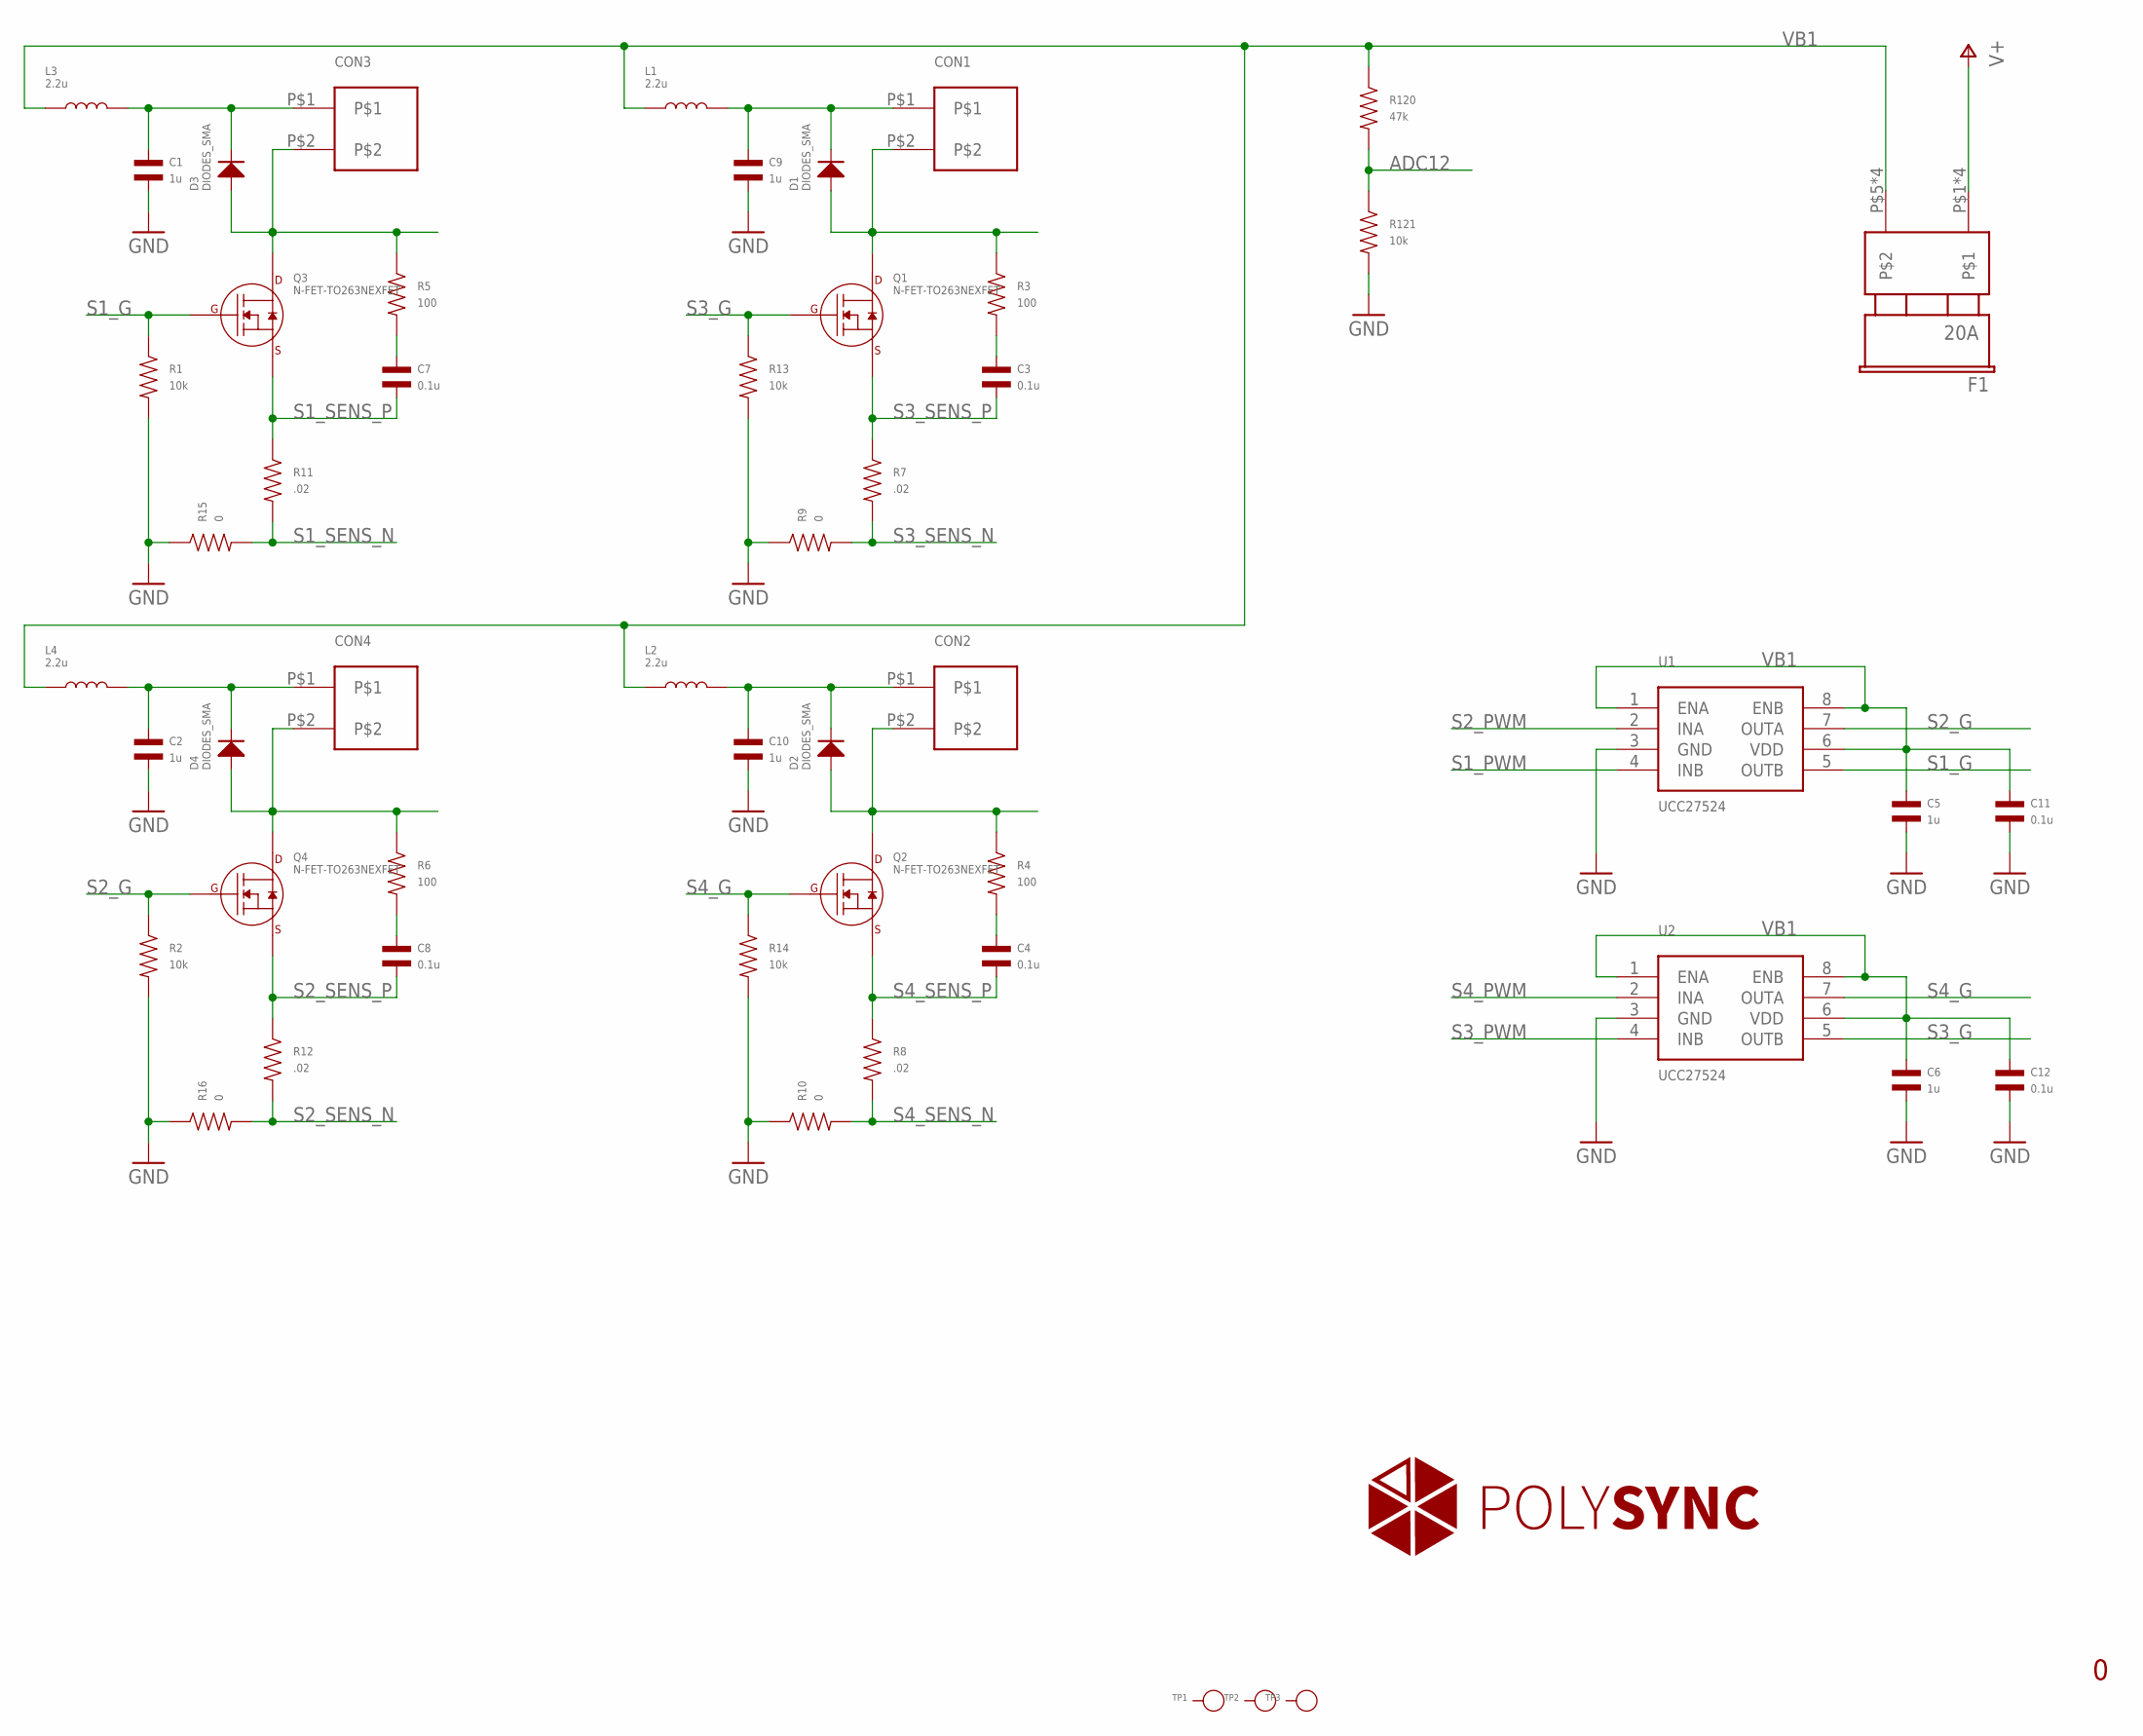
[picture p23: schematic actuator_control_1.2.0.sch, sheet 1, Solenoid Bank 1]

Parts:
C1, C2, C5, C6, C9, C10: 1u; C1206
C3, C4, C7, C8, C11, C12: 0.1u; C0805
CON1, CON2, CON3, CON4: CON23.5MM; PHOENIX_2_45
D1, D2, D4: DIODES_SMA; SMA
D3: DIODES_SMA; SMA; MPN US1B-13-F
F1: 20A; FUSE_ATO; PARTNO 178.6165.0001
L1, L2, L3, L4: 2.2u; SRP7050; PARTNO SRP7050TA-2R2M
Q1, Q2, Q3, Q4: N-FET-TO263NEXFET; SON8-DQJ
R1, R2, R13, R14, R121: 10k; R0402
R3, R4, R5, R6: 100; R0805
R7, R8, R11, R12: .02; R1206
R9, R10, R15, R16: 0; R0805
R120: 47k; R0402
TP1, TP2, TP3: PAD-TEST-POINT'4545'; TP_4545
U1, U2: UCC27524; SOIC-8

Connections:
ADC12: R120.P$2, R121.P$1; also elsewhere on the board
GND: C1.P$2, C2.P$2, C5.P$2, C6.P$2, C9.P$2, C10.P$2, C11.P$2, C12.P$2, R1.P$2, R2.P$2, R9.P$1, R10.P$1, R13.P$2, R14.P$2, R15.P$1, R16.P$1, R121.P$2, U1.3 (GND), U2.3 (GND); also elsewhere on the board
unnamed: C1.P$1, CON3.P$1, D3.CATHODE, L3.P$2
unnamed: CON3.P$2, D3.ANODE, Q3.P$5 (DRAIN), Q3.P$6 (DRAIN), Q3.P$7 (DRAIN), Q3.P$8 (DRAIN), Q3.P$9 (DRAIN), R5.P$1
unnamed: C7.P$1, R5.P$2
unnamed: C2.P$1, CON4.P$1, D4.CATHODE, L4.P$2
unnamed: CON4.P$2, D4.ANODE, Q4.P$5 (DRAIN), Q4.P$6 (DRAIN), Q4.P$7 (DRAIN), Q4.P$8 (DRAIN), Q4.P$9 (DRAIN), R6.P$1
unnamed: C8.P$1, R6.P$2
unnamed: C9.P$1, CON1.P$1, D1.CATHODE, L1.P$2
unnamed: CON1.P$2, D1.ANODE, Q1.P$5 (DRAIN), Q1.P$6 (DRAIN), Q1.P$7 (DRAIN), Q1.P$8 (DRAIN), Q1.P$9 (DRAIN), R3.P$1
unnamed: C3.P$1, R3.P$2
unnamed: C10.P$1, CON2.P$1, D2.CATHODE, L2.P$2
unnamed: CON2.P$2, D2.ANODE, Q2.P$5 (DRAIN), Q2.P$6 (DRAIN), Q2.P$7 (DRAIN), Q2.P$8 (DRAIN), Q2.P$9 (DRAIN), R4.P$1
unnamed: C4.P$1, R4.P$2
S1_G: Q3.P$4 (GATE), R1.P$1, U1.5 (OUTB)
S1_PWM: U1.4 (INB); also elsewhere on the board
S1_SENS_N: R11.P$2, R15.P$2; also elsewhere on the board
S1_SENS_P: C7.P$2, Q3.P$1 (SOURCE), Q3.P$2 (SOURCE), Q3.P$3 (SOURCE), R11.P$1; also elsewhere on the board
S2_G: Q4.P$4 (GATE), R2.P$1, U1.7 (OUTA)
S2_PWM: U1.2 (INA); also elsewhere on the board
S2_SENS_N: R12.P$2, R16.P$2; also elsewhere on the board
S2_SENS_P: C8.P$2, Q4.P$1 (SOURCE), Q4.P$2 (SOURCE), Q4.P$3 (SOURCE), R12.P$1; also elsewhere on the board
S3_G: Q1.P$4 (GATE), R13.P$1, U2.5 (OUTB)
S3_PWM: U2.4 (INB); also elsewhere on the board
S3_SENS_N: R7.P$2, R9.P$2; also elsewhere on the board
S3_SENS_P: C3.P$2, Q1.P$1 (SOURCE), Q1.P$2 (SOURCE), Q1.P$3 (SOURCE), R7.P$1; also elsewhere on the board
S4_G: Q2.P$4 (GATE), R14.P$1, U2.7 (OUTA)
S4_PWM: U2.2 (INA); also elsewhere on the board
S4_SENS_N: R8.P$2, R10.P$2; also elsewhere on the board
S4_SENS_P: C4.P$2, Q2.P$1 (SOURCE), Q2.P$2 (SOURCE), Q2.P$3 (SOURCE), R8.P$1; also elsewhere on the board
V+: F1.P$1, F1.P$2, F1.P$3, F1.P$4; also elsewhere on the board
VB1: C5.P$1, C6.P$1, C11.P$1, C12.P$1, F1.P$5, F1.P$6, F1.P$7, F1.P$8, L1.P$1, L2.P$1, L3.P$1, L4.P$1, R120.P$1, U1.1 (ENA), U1.6 (VDD), U1.8 (ENB), U2.1 (ENA), U2.6 (VDD), U2.8 (ENB); also elsewhere on the board

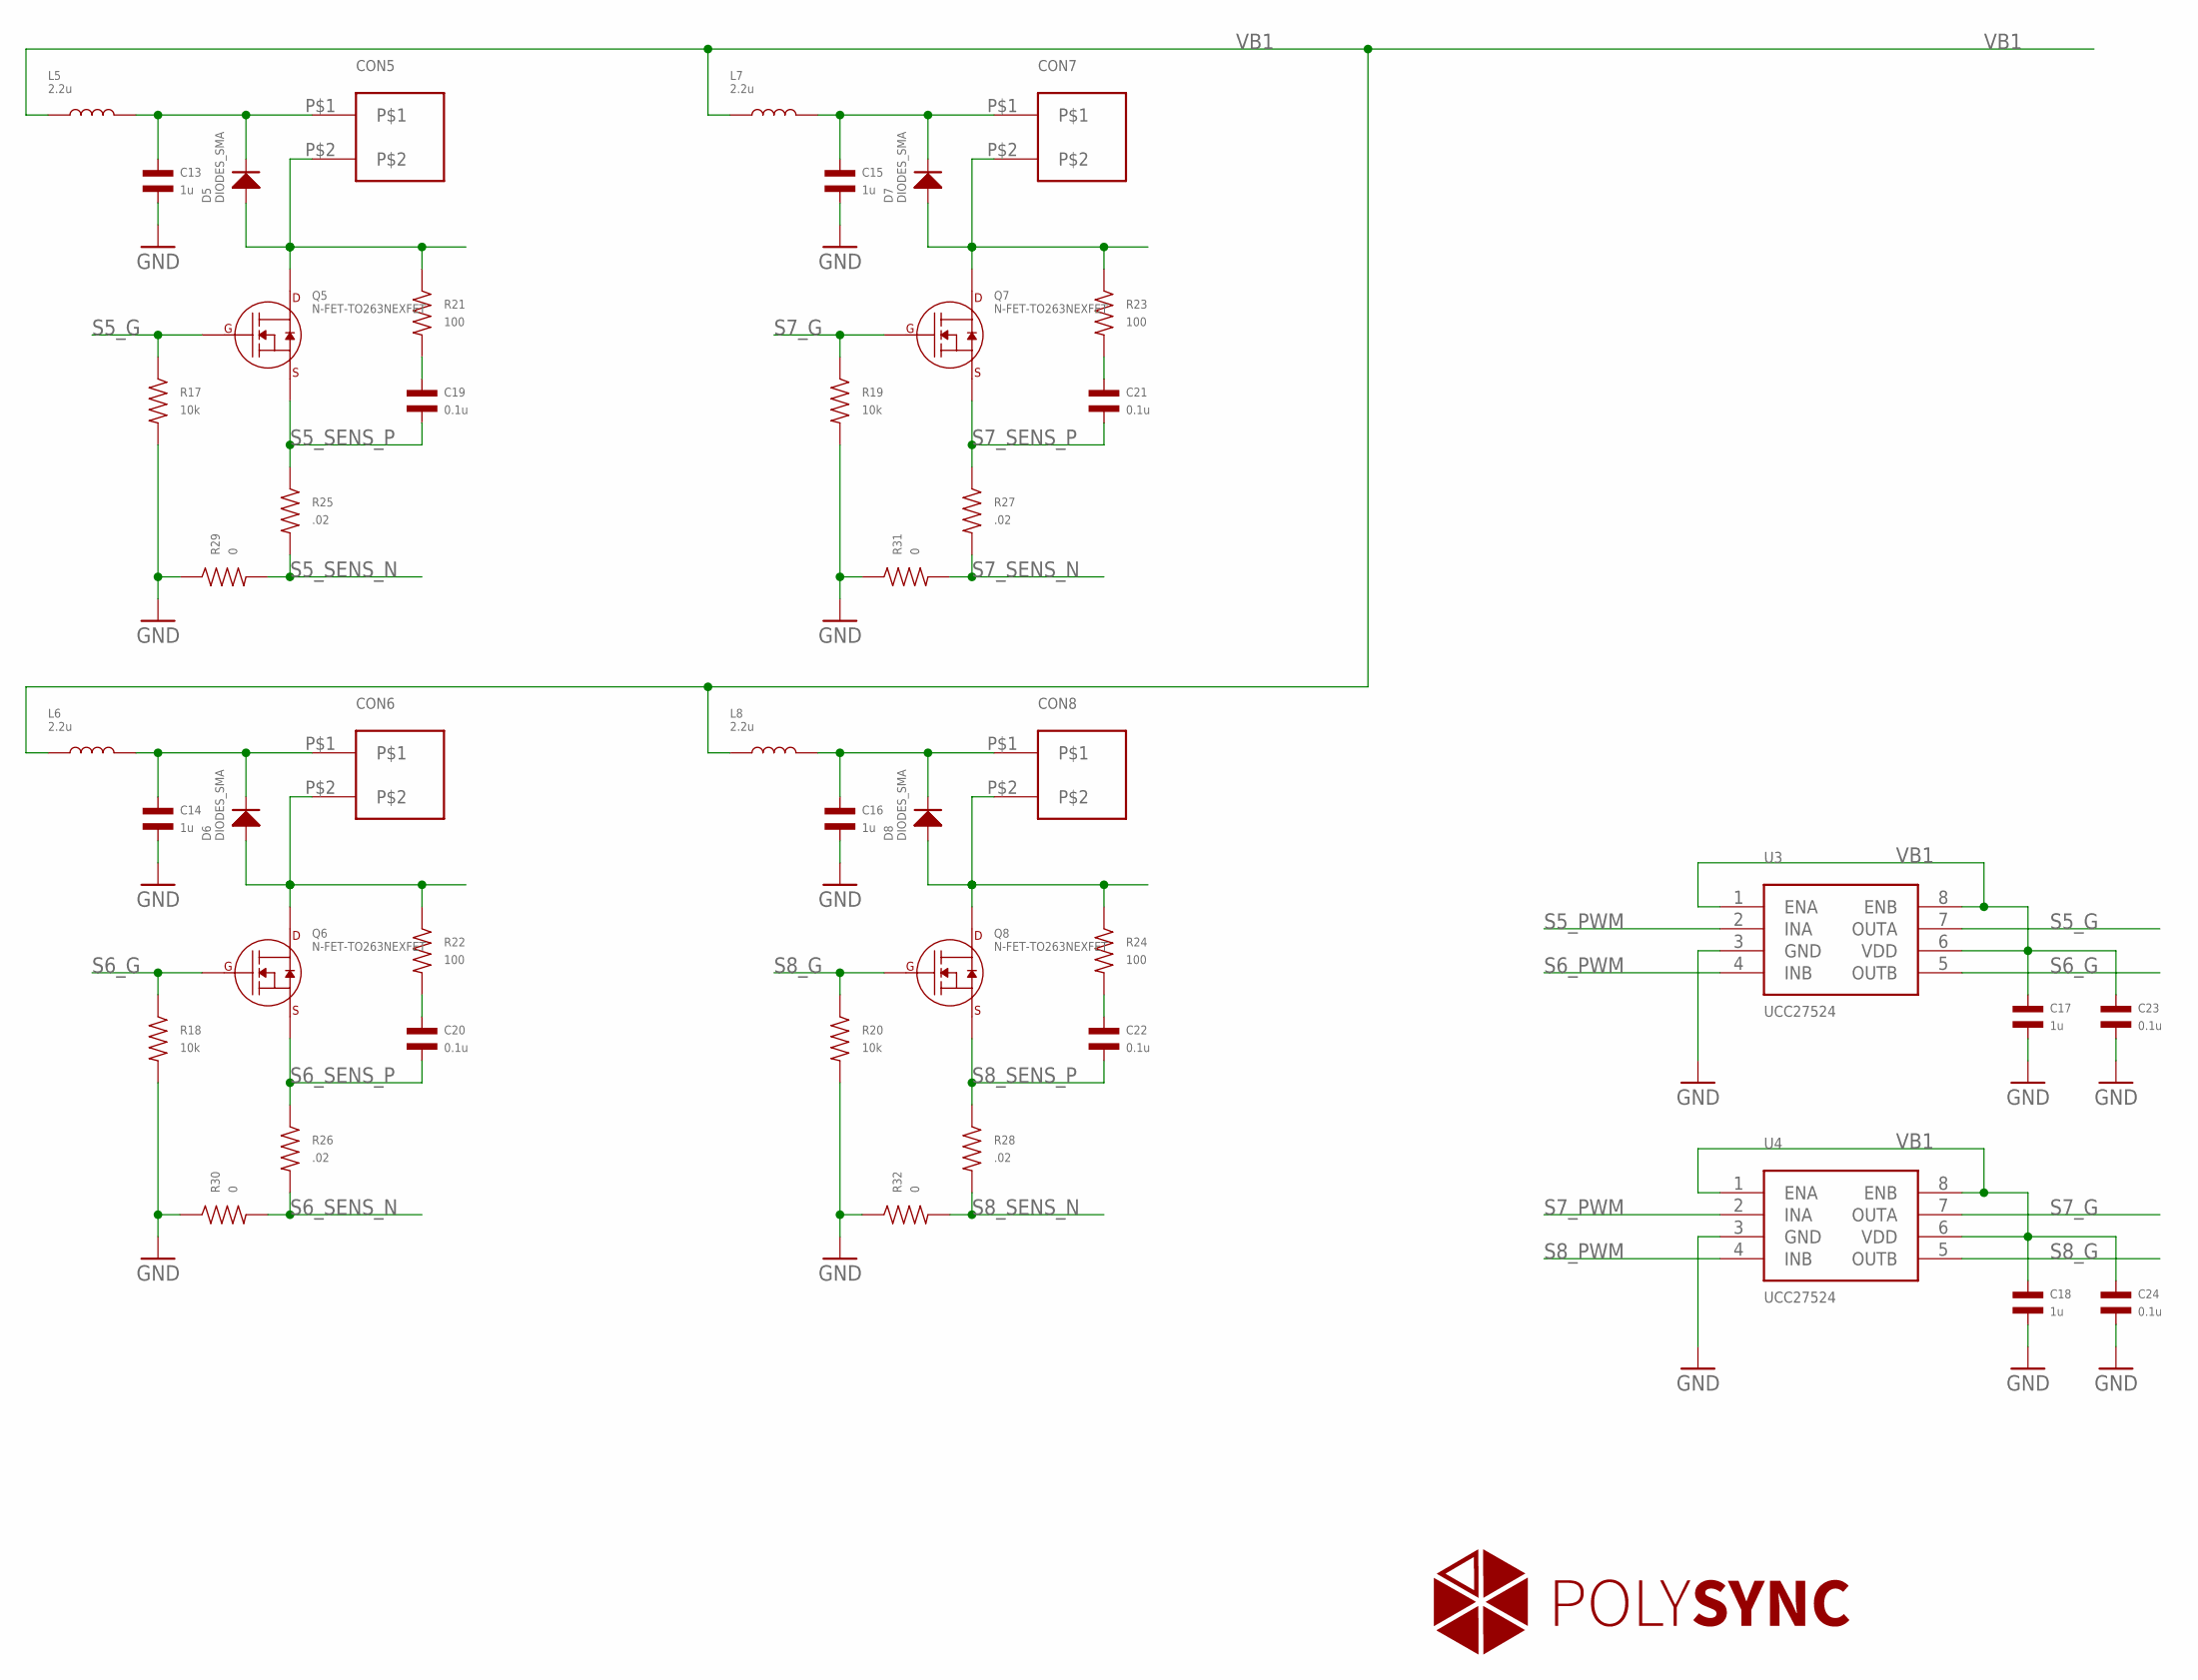
[picture p24: schematic actuator_control_1.2.0.sch, sheet 2, Solenoid Bank 2]

Parts:
C13, C14, C15, C16, C17, C18: 1u; C1206
C19, C20, C21, C22, C23, C24: 0.1u; C0805
CON5, CON6, CON7, CON8: CON23.5MM; PHOENIX_2_45
D5, D6, D7, D8: DIODES_SMA; SMA
L5, L6, L7, L8: 2.2u; SRP7050; PARTNO SRP7050TA-2R2M
Q5, Q6, Q7, Q8: N-FET-TO263NEXFET; SON8-DQJ
R17, R18, R19, R20: 10k; R0402
R21, R22, R23, R24: 100; R0805
R25, R26, R27, R28: .02; R1206
R29, R30, R31, R32: 0; R0805
U3, U4: UCC27524; SOIC-8

Connections:
GND: C13.P$2, C14.P$2, C15.P$2, C16.P$2, C17.P$2, C18.P$2, C23.P$2, C24.P$2, R17.P$2, R18.P$2, R19.P$2, R20.P$2, R29.P$1, R30.P$1, R31.P$1, R32.P$1, U3.3 (GND), U4.3 (GND); also elsewhere on the board
unnamed: C13.P$1, CON5.P$1, D5.CATHODE, L5.P$2
unnamed: CON5.P$2, D5.ANODE, Q5.P$5 (DRAIN), Q5.P$6 (DRAIN), Q5.P$7 (DRAIN), Q5.P$8 (DRAIN), Q5.P$9 (DRAIN), R21.P$1
unnamed: C19.P$1, R21.P$2
unnamed: C14.P$1, CON6.P$1, D6.CATHODE, L6.P$2
unnamed: CON6.P$2, D6.ANODE, Q6.P$5 (DRAIN), Q6.P$6 (DRAIN), Q6.P$7 (DRAIN), Q6.P$8 (DRAIN), Q6.P$9 (DRAIN), R22.P$1
unnamed: C20.P$1, R22.P$2
unnamed: C15.P$1, CON7.P$1, D7.CATHODE, L7.P$2
unnamed: CON7.P$2, D7.ANODE, Q7.P$5 (DRAIN), Q7.P$6 (DRAIN), Q7.P$7 (DRAIN), Q7.P$8 (DRAIN), Q7.P$9 (DRAIN), R23.P$1
unnamed: C21.P$1, R23.P$2
unnamed: C16.P$1, CON8.P$1, D8.CATHODE, L8.P$2
unnamed: CON8.P$2, D8.ANODE, Q8.P$5 (DRAIN), Q8.P$6 (DRAIN), Q8.P$7 (DRAIN), Q8.P$8 (DRAIN), Q8.P$9 (DRAIN), R24.P$1
unnamed: C22.P$1, R24.P$2
S5_G: Q5.P$4 (GATE), R17.P$1, U3.7 (OUTA)
S5_PWM: U3.2 (INA); also elsewhere on the board
S5_SENS_N: R25.P$2, R29.P$2; also elsewhere on the board
S5_SENS_P: C19.P$2, Q5.P$1 (SOURCE), Q5.P$2 (SOURCE), Q5.P$3 (SOURCE), R25.P$1; also elsewhere on the board
S6_G: Q6.P$4 (GATE), R18.P$1, U3.5 (OUTB)
S6_PWM: U3.4 (INB); also elsewhere on the board
S6_SENS_N: R26.P$2, R30.P$2; also elsewhere on the board
S6_SENS_P: C20.P$2, Q6.P$1 (SOURCE), Q6.P$2 (SOURCE), Q6.P$3 (SOURCE), R26.P$1; also elsewhere on the board
S7_G: Q7.P$4 (GATE), R19.P$1, U4.7 (OUTA)
S7_PWM: U4.2 (INA); also elsewhere on the board
S7_SENS_N: R27.P$2, R31.P$2; also elsewhere on the board
S7_SENS_P: C21.P$2, Q7.P$1 (SOURCE), Q7.P$2 (SOURCE), Q7.P$3 (SOURCE), R27.P$1; also elsewhere on the board
S8_G: Q8.P$4 (GATE), R20.P$1, U4.5 (OUTB)
S8_PWM: U4.4 (INB); also elsewhere on the board
S8_SENS_N: R28.P$2, R32.P$2; also elsewhere on the board
S8_SENS_P: C22.P$2, Q8.P$1 (SOURCE), Q8.P$2 (SOURCE), Q8.P$3 (SOURCE), R28.P$1; also elsewhere on the board
VB1: C17.P$1, C18.P$1, C23.P$1, C24.P$1, L5.P$1, L6.P$1, L7.P$1, L8.P$1, U3.1 (ENA), U3.6 (VDD), U3.8 (ENB), U4.1 (ENA), U4.6 (VDD), U4.8 (ENB); also elsewhere on the board

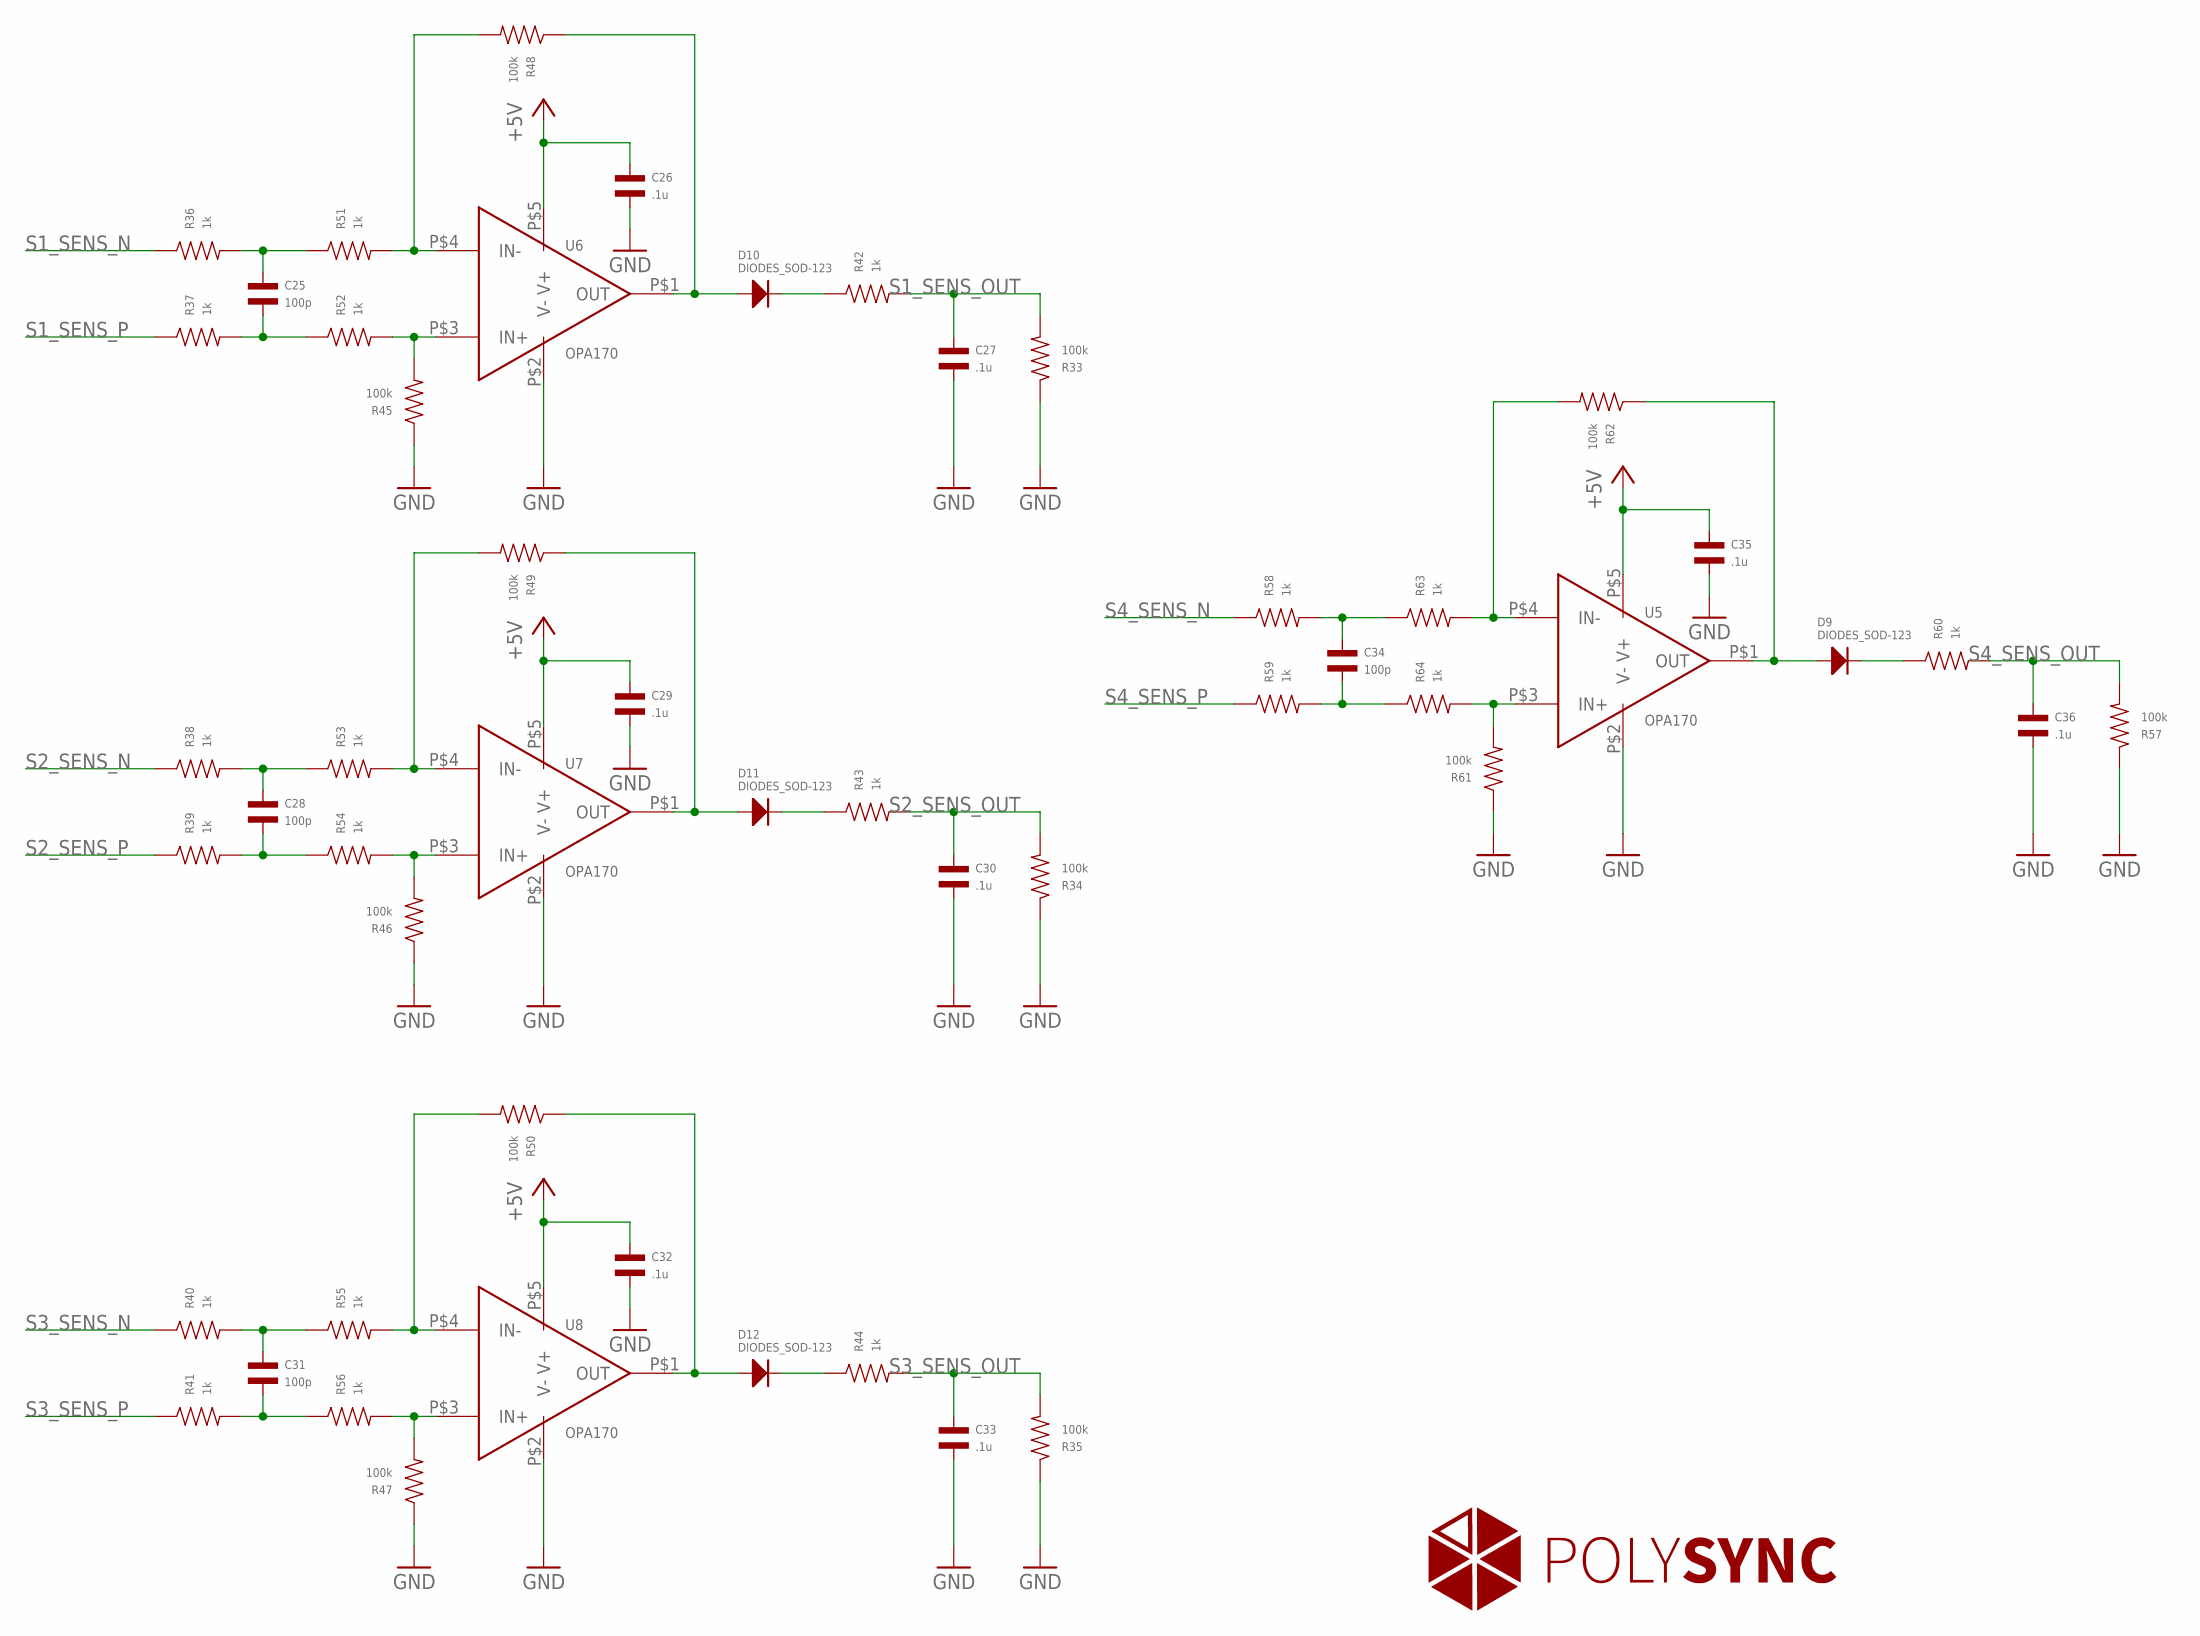
[picture p25: schematic actuator_control_1.2.0.sch, sheet 3, Current Sense Bank 1]

Parts:
C25, C28, C31, C34: 100p; C0402
C26, C27, C29, C30, C32, C33, C35, C36: .1u; C0402
D9, D10, D11, D12: DIODES_SOD-123; SOD-123
R33, R34, R35, R45, R46, R47, R48, R49, R50, R57, R61, R62: 100k; R0402
R36, R37, R38, R39, R40, R41, R42, R43, R44, R51, R52, R53, R54, R55, R56, R58, R59, R60, R63, R64: 1k; R0402
U5, U6, U7, U8: OPA170; SOT-23-5

Connections:
+5V: C26.P$1, C29.P$1, C32.P$1, C35.P$1, U5.P$5 (V+), U6.P$5 (V+), U7.P$5 (V+), U8.P$5 (V+); also elsewhere on the board
GND: C26.P$2, C27.P$2, C29.P$2, C30.P$2, C32.P$2, C33.P$2, C35.P$2, C36.P$2, R33.P$1, R34.P$1, R35.P$1, R45.P$1, R46.P$1, R47.P$1, R57.P$1, R61.P$1, U5.P$2 (V-), U6.P$2 (V-), U7.P$2 (V-), U8.P$2 (V-); also elsewhere on the board
unnamed: R48.P$2, R51.P$2, U6.P$4 (IN-)
unnamed: R45.P$2, R52.P$2, U6.P$3 (IN+)
unnamed: C25.P$2, R37.P$2, R52.P$1
unnamed: C25.P$1, R36.P$2, R51.P$1
unnamed: D10.ANODE, R48.P$1, U6.P$1 (OUT)
unnamed: D10.CATHODE, R42.P$1
unnamed: R49.P$2, R53.P$2, U7.P$4 (IN-)
unnamed: R46.P$2, R54.P$2, U7.P$3 (IN+)
unnamed: C28.P$2, R39.P$2, R54.P$1
unnamed: C28.P$1, R38.P$2, R53.P$1
unnamed: D11.ANODE, R49.P$1, U7.P$1 (OUT)
unnamed: D11.CATHODE, R43.P$1
unnamed: R50.P$2, R55.P$2, U8.P$4 (IN-)
unnamed: R47.P$2, R56.P$2, U8.P$3 (IN+)
unnamed: C31.P$2, R41.P$2, R56.P$1
unnamed: C31.P$1, R40.P$2, R55.P$1
unnamed: D12.ANODE, R50.P$1, U8.P$1 (OUT)
unnamed: D12.CATHODE, R44.P$1
unnamed: R62.P$2, R63.P$2, U5.P$4 (IN-)
unnamed: R61.P$2, R64.P$2, U5.P$3 (IN+)
unnamed: C34.P$2, R59.P$2, R64.P$1
unnamed: C34.P$1, R58.P$2, R63.P$1
unnamed: D9.ANODE, R62.P$1, U5.P$1 (OUT)
unnamed: D9.CATHODE, R60.P$1
S1_SENS_N: R36.P$1; also elsewhere on the board
S1_SENS_OUT: C27.P$1, R33.P$2, R42.P$2; also elsewhere on the board
S1_SENS_P: R37.P$1; also elsewhere on the board
S2_SENS_N: R38.P$1; also elsewhere on the board
S2_SENS_OUT: C30.P$1, R34.P$2, R43.P$2; also elsewhere on the board
S2_SENS_P: R39.P$1; also elsewhere on the board
S3_SENS_N: R40.P$1; also elsewhere on the board
S3_SENS_OUT: C33.P$1, R35.P$2, R44.P$2; also elsewhere on the board
S3_SENS_P: R41.P$1; also elsewhere on the board
S4_SENS_N: R58.P$1; also elsewhere on the board
S4_SENS_OUT: C36.P$1, R57.P$2, R60.P$2; also elsewhere on the board
S4_SENS_P: R59.P$1; also elsewhere on the board

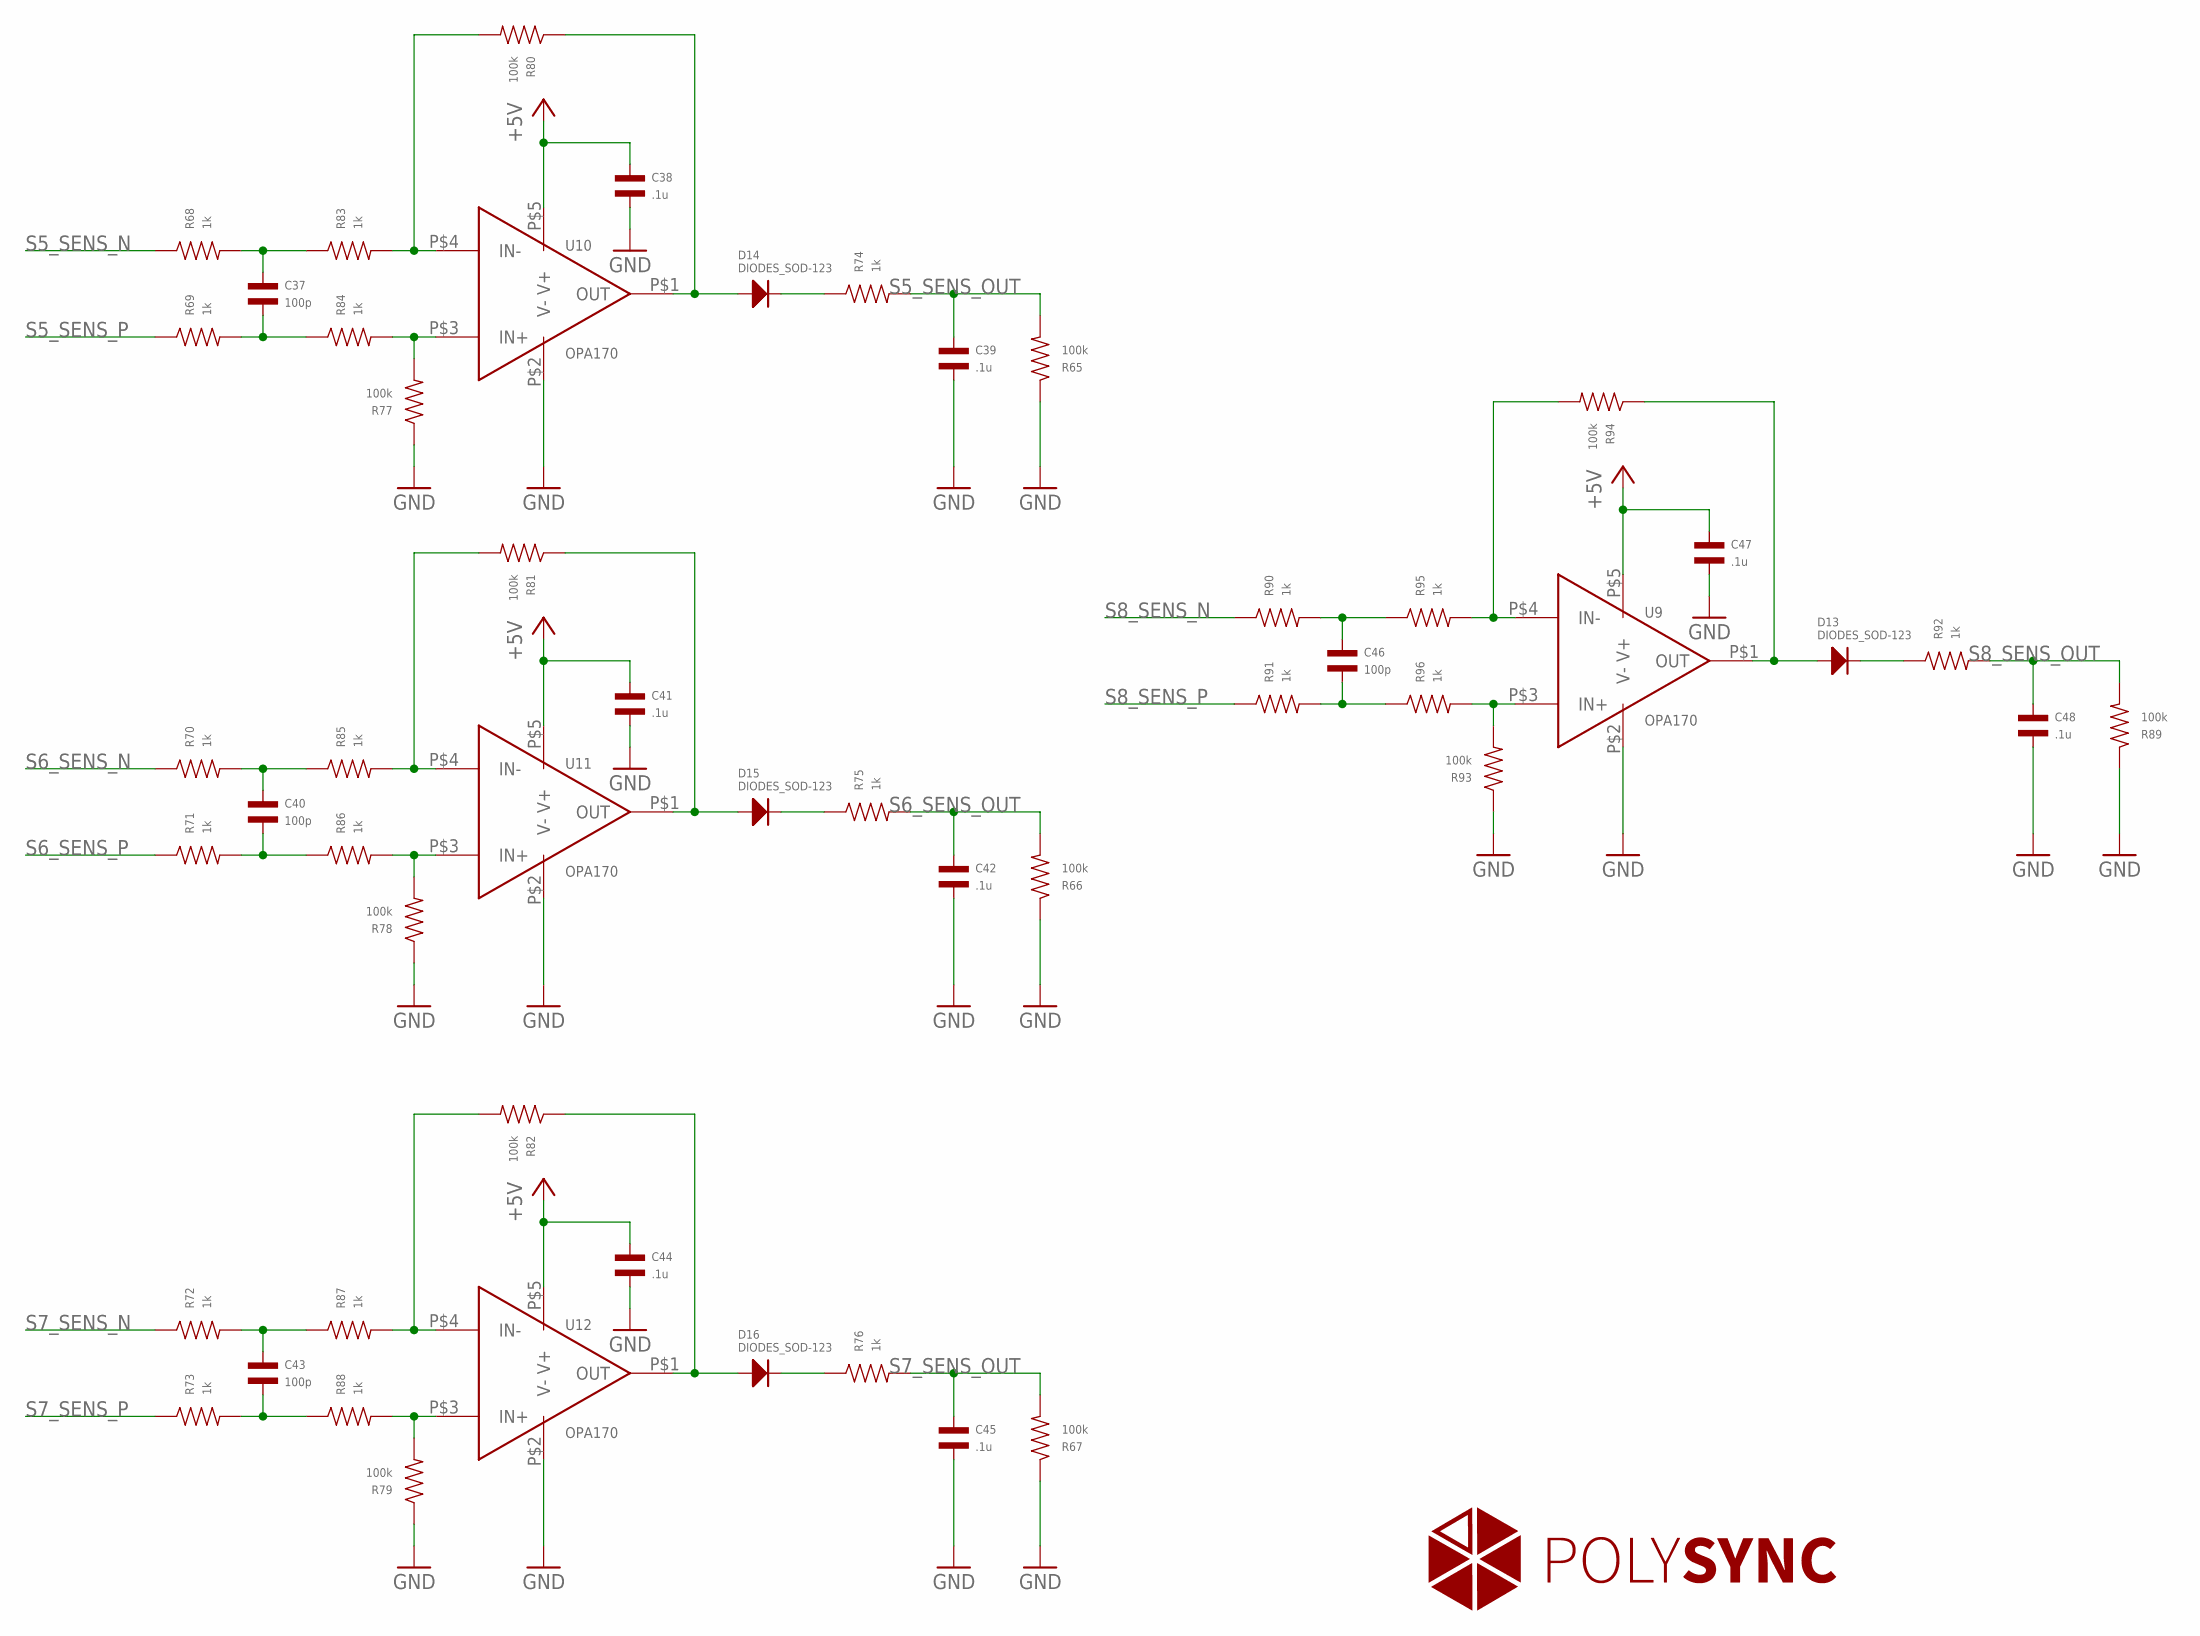
[picture p26: schematic actuator_control_1.2.0.sch, sheet 4, Current Sense Bank 2]

Parts:
C37, C40, C43, C46: 100p; C0402
C38, C39, C41, C42, C44, C45, C47, C48: .1u; C0402
D13, D14, D15, D16: DIODES_SOD-123; SOD-123
R65, R66, R67, R77, R78, R79, R80, R81, R82, R89, R93, R94: 100k; R0402
R68, R69, R70, R71, R72, R73, R74, R75, R76, R83, R84, R85, R86, R87, R88, R90, R91, R92, R95, R96: 1k; R0402
U9, U10, U11, U12: OPA170; SOT-23-5

Connections:
+5V: C38.P$1, C41.P$1, C44.P$1, C47.P$1, U9.P$5 (V+), U10.P$5 (V+), U11.P$5 (V+), U12.P$5 (V+); also elsewhere on the board
GND: C38.P$2, C39.P$2, C41.P$2, C42.P$2, C44.P$2, C45.P$2, C47.P$2, C48.P$2, R65.P$1, R66.P$1, R67.P$1, R77.P$1, R78.P$1, R79.P$1, R89.P$1, R93.P$1, U9.P$2 (V-), U10.P$2 (V-), U11.P$2 (V-), U12.P$2 (V-); also elsewhere on the board
unnamed: R80.P$2, R83.P$2, U10.P$4 (IN-)
unnamed: R77.P$2, R84.P$2, U10.P$3 (IN+)
unnamed: C37.P$2, R69.P$2, R84.P$1
unnamed: C37.P$1, R68.P$2, R83.P$1
unnamed: D14.ANODE, R80.P$1, U10.P$1 (OUT)
unnamed: D14.CATHODE, R74.P$1
unnamed: R81.P$2, R85.P$2, U11.P$4 (IN-)
unnamed: R78.P$2, R86.P$2, U11.P$3 (IN+)
unnamed: C40.P$2, R71.P$2, R86.P$1
unnamed: C40.P$1, R70.P$2, R85.P$1
unnamed: D15.ANODE, R81.P$1, U11.P$1 (OUT)
unnamed: D15.CATHODE, R75.P$1
unnamed: R82.P$2, R87.P$2, U12.P$4 (IN-)
unnamed: R79.P$2, R88.P$2, U12.P$3 (IN+)
unnamed: C43.P$2, R73.P$2, R88.P$1
unnamed: C43.P$1, R72.P$2, R87.P$1
unnamed: D16.ANODE, R82.P$1, U12.P$1 (OUT)
unnamed: D16.CATHODE, R76.P$1
unnamed: R94.P$2, R95.P$2, U9.P$4 (IN-)
unnamed: R93.P$2, R96.P$2, U9.P$3 (IN+)
unnamed: C46.P$2, R91.P$2, R96.P$1
unnamed: C46.P$1, R90.P$2, R95.P$1
unnamed: D13.ANODE, R94.P$1, U9.P$1 (OUT)
unnamed: D13.CATHODE, R92.P$1
S5_SENS_N: R68.P$1; also elsewhere on the board
S5_SENS_OUT: C39.P$1, R65.P$2, R74.P$2; also elsewhere on the board
S5_SENS_P: R69.P$1; also elsewhere on the board
S6_SENS_N: R70.P$1; also elsewhere on the board
S6_SENS_OUT: C42.P$1, R66.P$2, R75.P$2; also elsewhere on the board
S6_SENS_P: R71.P$1; also elsewhere on the board
S7_SENS_N: R72.P$1; also elsewhere on the board
S7_SENS_OUT: C45.P$1, R67.P$2, R76.P$2; also elsewhere on the board
S7_SENS_P: R73.P$1; also elsewhere on the board
S8_SENS_N: R90.P$1; also elsewhere on the board
S8_SENS_OUT: C48.P$1, R89.P$2, R92.P$2; also elsewhere on the board
S8_SENS_P: R91.P$1; also elsewhere on the board
