WATonomous/interfacing-mono/DBW-boards/actuator_control/actuator_control_1.2.0.brd

## EAGLE design DBW-boards/actuator_control/actuator_control_1.2.0.brd (continued)

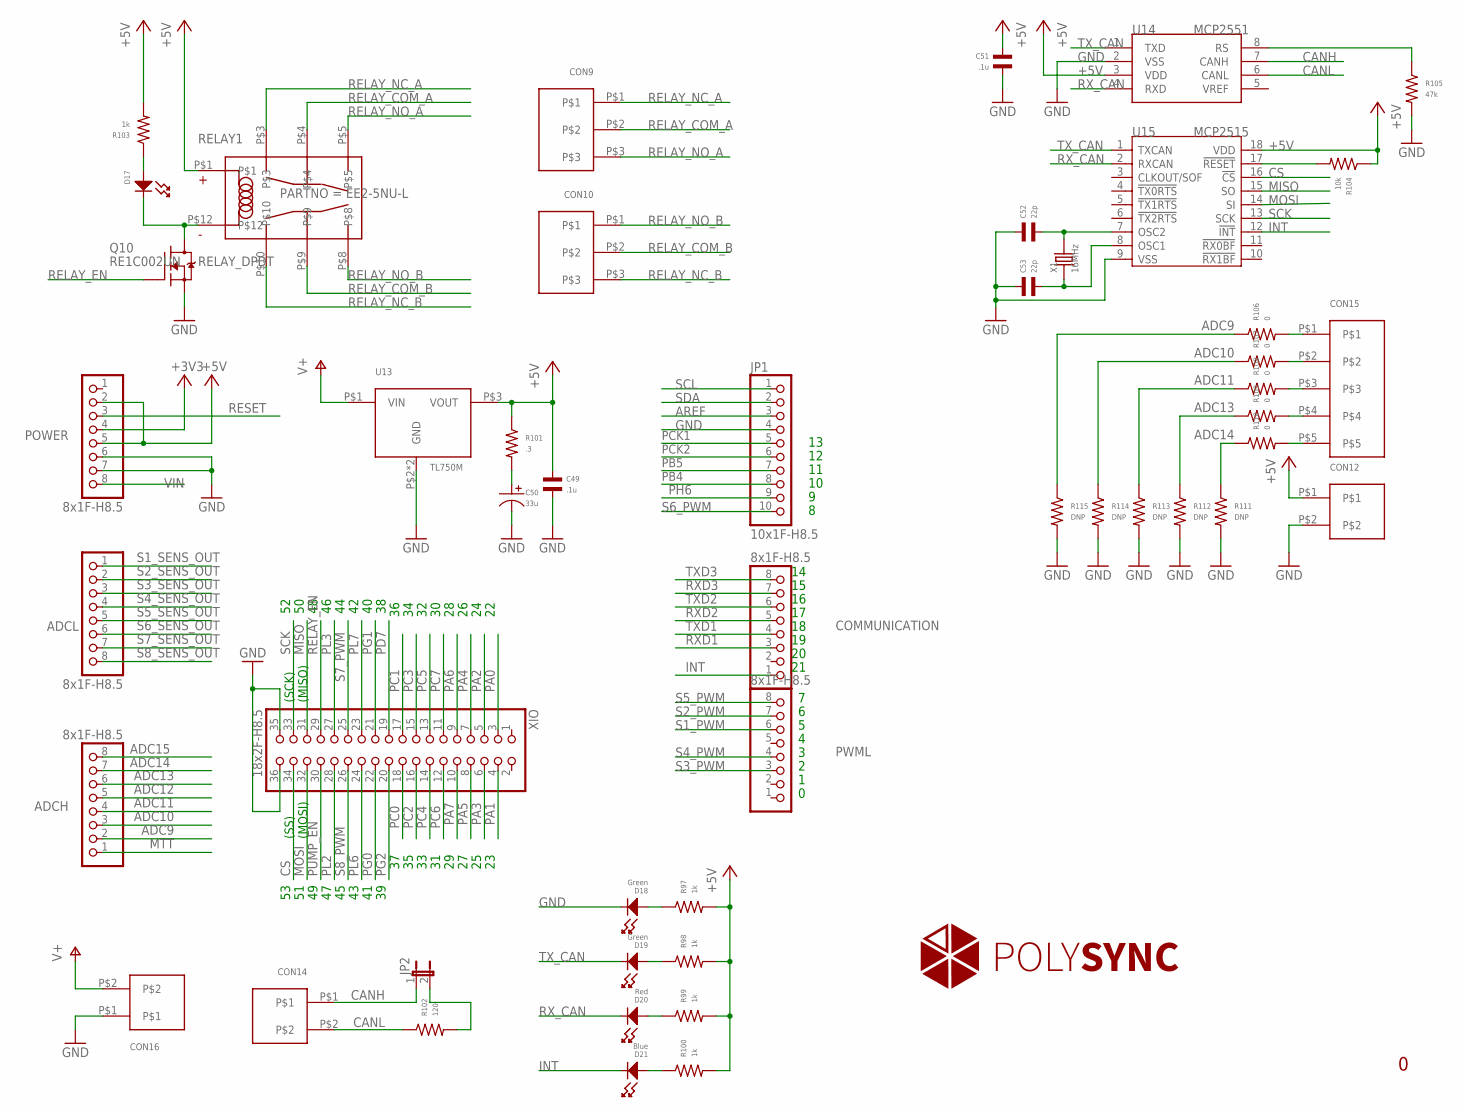
[picture p27: schematic actuator_control_1.2.0.sch, sheet 5, Connectors, CAN, Pump Relay]

Parts:
ADCH: 8x1F-H8.5; 1X08
ADCL: 8x1F-H8.5; 1X08
C49, C51: .1u; C0402
C50: 33u; CP1206
C52, C53: 22p; C0402
COMMUNICATION: 8x1F-H8.5; 1X08
CON9, CON10: CON3; PHOENIX_3_45
CON12, CON14: CON23.5MM; PHOENIX_2_45
CON15: CON5; PHOENIX_5_45
CON16: CON23.5MM; PHOENIX_2_45; PARTNO 1773976
D17: LED_SINGLE-0603; LED0603
D18, D19: Green; LED0603
D20: Red; LED0603
D21: Blue; LED0603
JP1: 10x1F-H8.5; 1X10
JP2: JP1E; JP1
POWER: 8x1F-H8.5; 1X08
PWML: 8x1F-H8.5; 1X08
Q10: RE1C002UN; EMT3F
R97, R98, R99, R100, R103: 1k; R0402
R101: .3; R0402
R102: 120; R0402
R104: 10k; R0402
R105: 47k; R0402
R106, R107, R108, R109, R110: 0; R0402
R111, R112, R113, R114, R115: DNP; R0402
RELAY1: RELAY_DPDT; KEMET_EE2; PARTNO EE2-5NU-L
U13: TL750M; TO-263
U14: MCP2551; SOIC8-6.0
U15: MCP2515; SOIC18
X1: 16MHz; HC49UP
XIO: 18x2F-H8.5; 2X18

Connections:
+3V3: POWER.4
+5V: C49.P$1, C51.P$1, CON12.P$1, POWER.2, POWER.5, R97.P$2, R98.P$2, R99.P$2, R100.P$2, R101.P$1, R103.P$2, R104.P$1, RELAY1.P$1, U13.P$3 (VOUT), U14.3 (VDD), U15.18 (VDD); also elsewhere on the board
ADC9: ADCH.2, R106.P$1, R115.P$1
ADC10: ADCH.3, R107.P$1, R114.P$1
ADC11: ADCH.4, R108.P$1, R113.P$1
ADC12: ADCH.5; also elsewhere on the board
ADC13: ADCH.6, R109.P$1, R112.P$1
ADC14: ADCH.7, R110.P$1, R111.P$1
ADC15: ADCH.8
AREF: JP1.3
CANH: CON14.P$1, JP2.1, U14.7 (CANH)
CANL: CON14.P$2, R102.P$1, U14.6 (CANL)
CS: U15.16 (!CS), XIO.34
GND: C49.P$2, C50.P$2, C51.P$2, C52.P$1, C53.P$1, CON12.P$2, CON16.P$1, D18.CATHODE, JP1.4, POWER.6, POWER.7, Q10.P$2 (S), R105.P$2, R111.P$2, R112.P$2, R113.P$2, R114.P$2, R115.P$2, U13.P$2 (GND), U13.P$4 (GND), U14.2 (VSS), U15.9 (VSS), XIO.35, XIO.36; also elsewhere on the board
INT: COMMUNICATION.1, D21.CATHODE, U15.12 (!INT)
MISO: U15.15 (SO), XIO.31
MOSI: U15.14 (SI), XIO.32
MTT: ADCH.1; also elsewhere on the board
unnamed: CON15.P$1, R106.P$2
unnamed: CON15.P$2, R107.P$2
unnamed: CON15.P$3, R108.P$2
unnamed: C52.P$2, U15.7 (OSC2), X1.2
unnamed: C53.P$2, U15.8 (OSC1), X1.1
unnamed: D17.CATHODE, Q10.P$3 (D), RELAY1.P$12
unnamed: D18.ANODE, R97.P$1
unnamed: D19.ANODE, R98.P$1
unnamed: D20.ANODE, R99.P$1
unnamed: D21.ANODE, R100.P$1
unnamed: R105.P$1, U14.8 (RS)
unnamed: D17.ANODE, R103.P$1
unnamed: CON15.P$4, R109.P$2
unnamed: CON15.P$5, R110.P$2
unnamed: C50.P$1, R101.P$2
unnamed: JP2.2, R102.P$2
PA0: XIO.3
PA1: XIO.4
PA2: XIO.5
PA3: XIO.6
PA4: XIO.7
PA5: XIO.8
PA6: XIO.9
PA7: XIO.10
PB4: JP1.8
PB5: JP1.7
PC0: XIO.18
PC1: XIO.17
PC2: XIO.16
PC3: XIO.15
PC4: XIO.14
PC5: XIO.13
PC6: XIO.12
PC7: XIO.11
PCK1: JP1.5; also elsewhere on the board
PCK2: JP1.6; also elsewhere on the board
PD7: XIO.19
PG0: XIO.22
PG1: XIO.21
PG2: XIO.20
PH6: JP1.9
PL2: XIO.28
PL3: XIO.27
PL6: XIO.24
PL7: XIO.23
PUMP_EN: XIO.30; also elsewhere on the board
RELAY_COM_A: CON9.P$2, RELAY1.P$4
RELAY_COM_B: CON10.P$2, RELAY1.P$9
RELAY_EN: Q10.P$1 (G), XIO.29
RELAY_NC_A: CON9.P$1, RELAY1.P$3
RELAY_NC_B: CON10.P$3, RELAY1.P$10
RELAY_NO_A: CON9.P$3, RELAY1.P$5
RELAY_NO_B: CON10.P$1, RELAY1.P$8
RESET: POWER.3
RST_N2: R104.P$2, U15.17 (!RESET)
RXD1: COMMUNICATION.3
RXD2: COMMUNICATION.5
RXD3: COMMUNICATION.7
RX_CAN: D20.CATHODE, U14.4 (RXD), U15.2 (RXCAN)
S1_PWM: PWML.6; also elsewhere on the board
S1_SENS_OUT: ADCL.1; also elsewhere on the board
S2_PWM: PWML.7; also elsewhere on the board
S2_SENS_OUT: ADCL.2; also elsewhere on the board
S3_PWM: PWML.3; also elsewhere on the board
S3_SENS_OUT: ADCL.3; also elsewhere on the board
S4_PWM: PWML.4; also elsewhere on the board
S4_SENS_OUT: ADCL.4; also elsewhere on the board
S5_PWM: PWML.8; also elsewhere on the board
S5_SENS_OUT: ADCL.5; also elsewhere on the board
S6_PWM: JP1.10; also elsewhere on the board
S6_SENS_OUT: ADCL.6; also elsewhere on the board
S7_PWM: XIO.25; also elsewhere on the board
S7_SENS_OUT: ADCL.7; also elsewhere on the board
S8_PWM: XIO.26; also elsewhere on the board
S8_SENS_OUT: ADCL.8; also elsewhere on the board
SCK: U15.13 (SCK), XIO.33
SCL: JP1.1
SDA: JP1.2
TXD1: COMMUNICATION.4
TXD2: COMMUNICATION.6
TXD3: COMMUNICATION.8
TX_CAN: D19.CATHODE, U14.1 (TXD), U15.1 (TXCAN)
V+: CON16.P$2, U13.P$1 (VIN); also elsewhere on the board
VIN: POWER.8

Notes on the sheet:
(SS)
(MOSI)
(SCK)
(MISO)

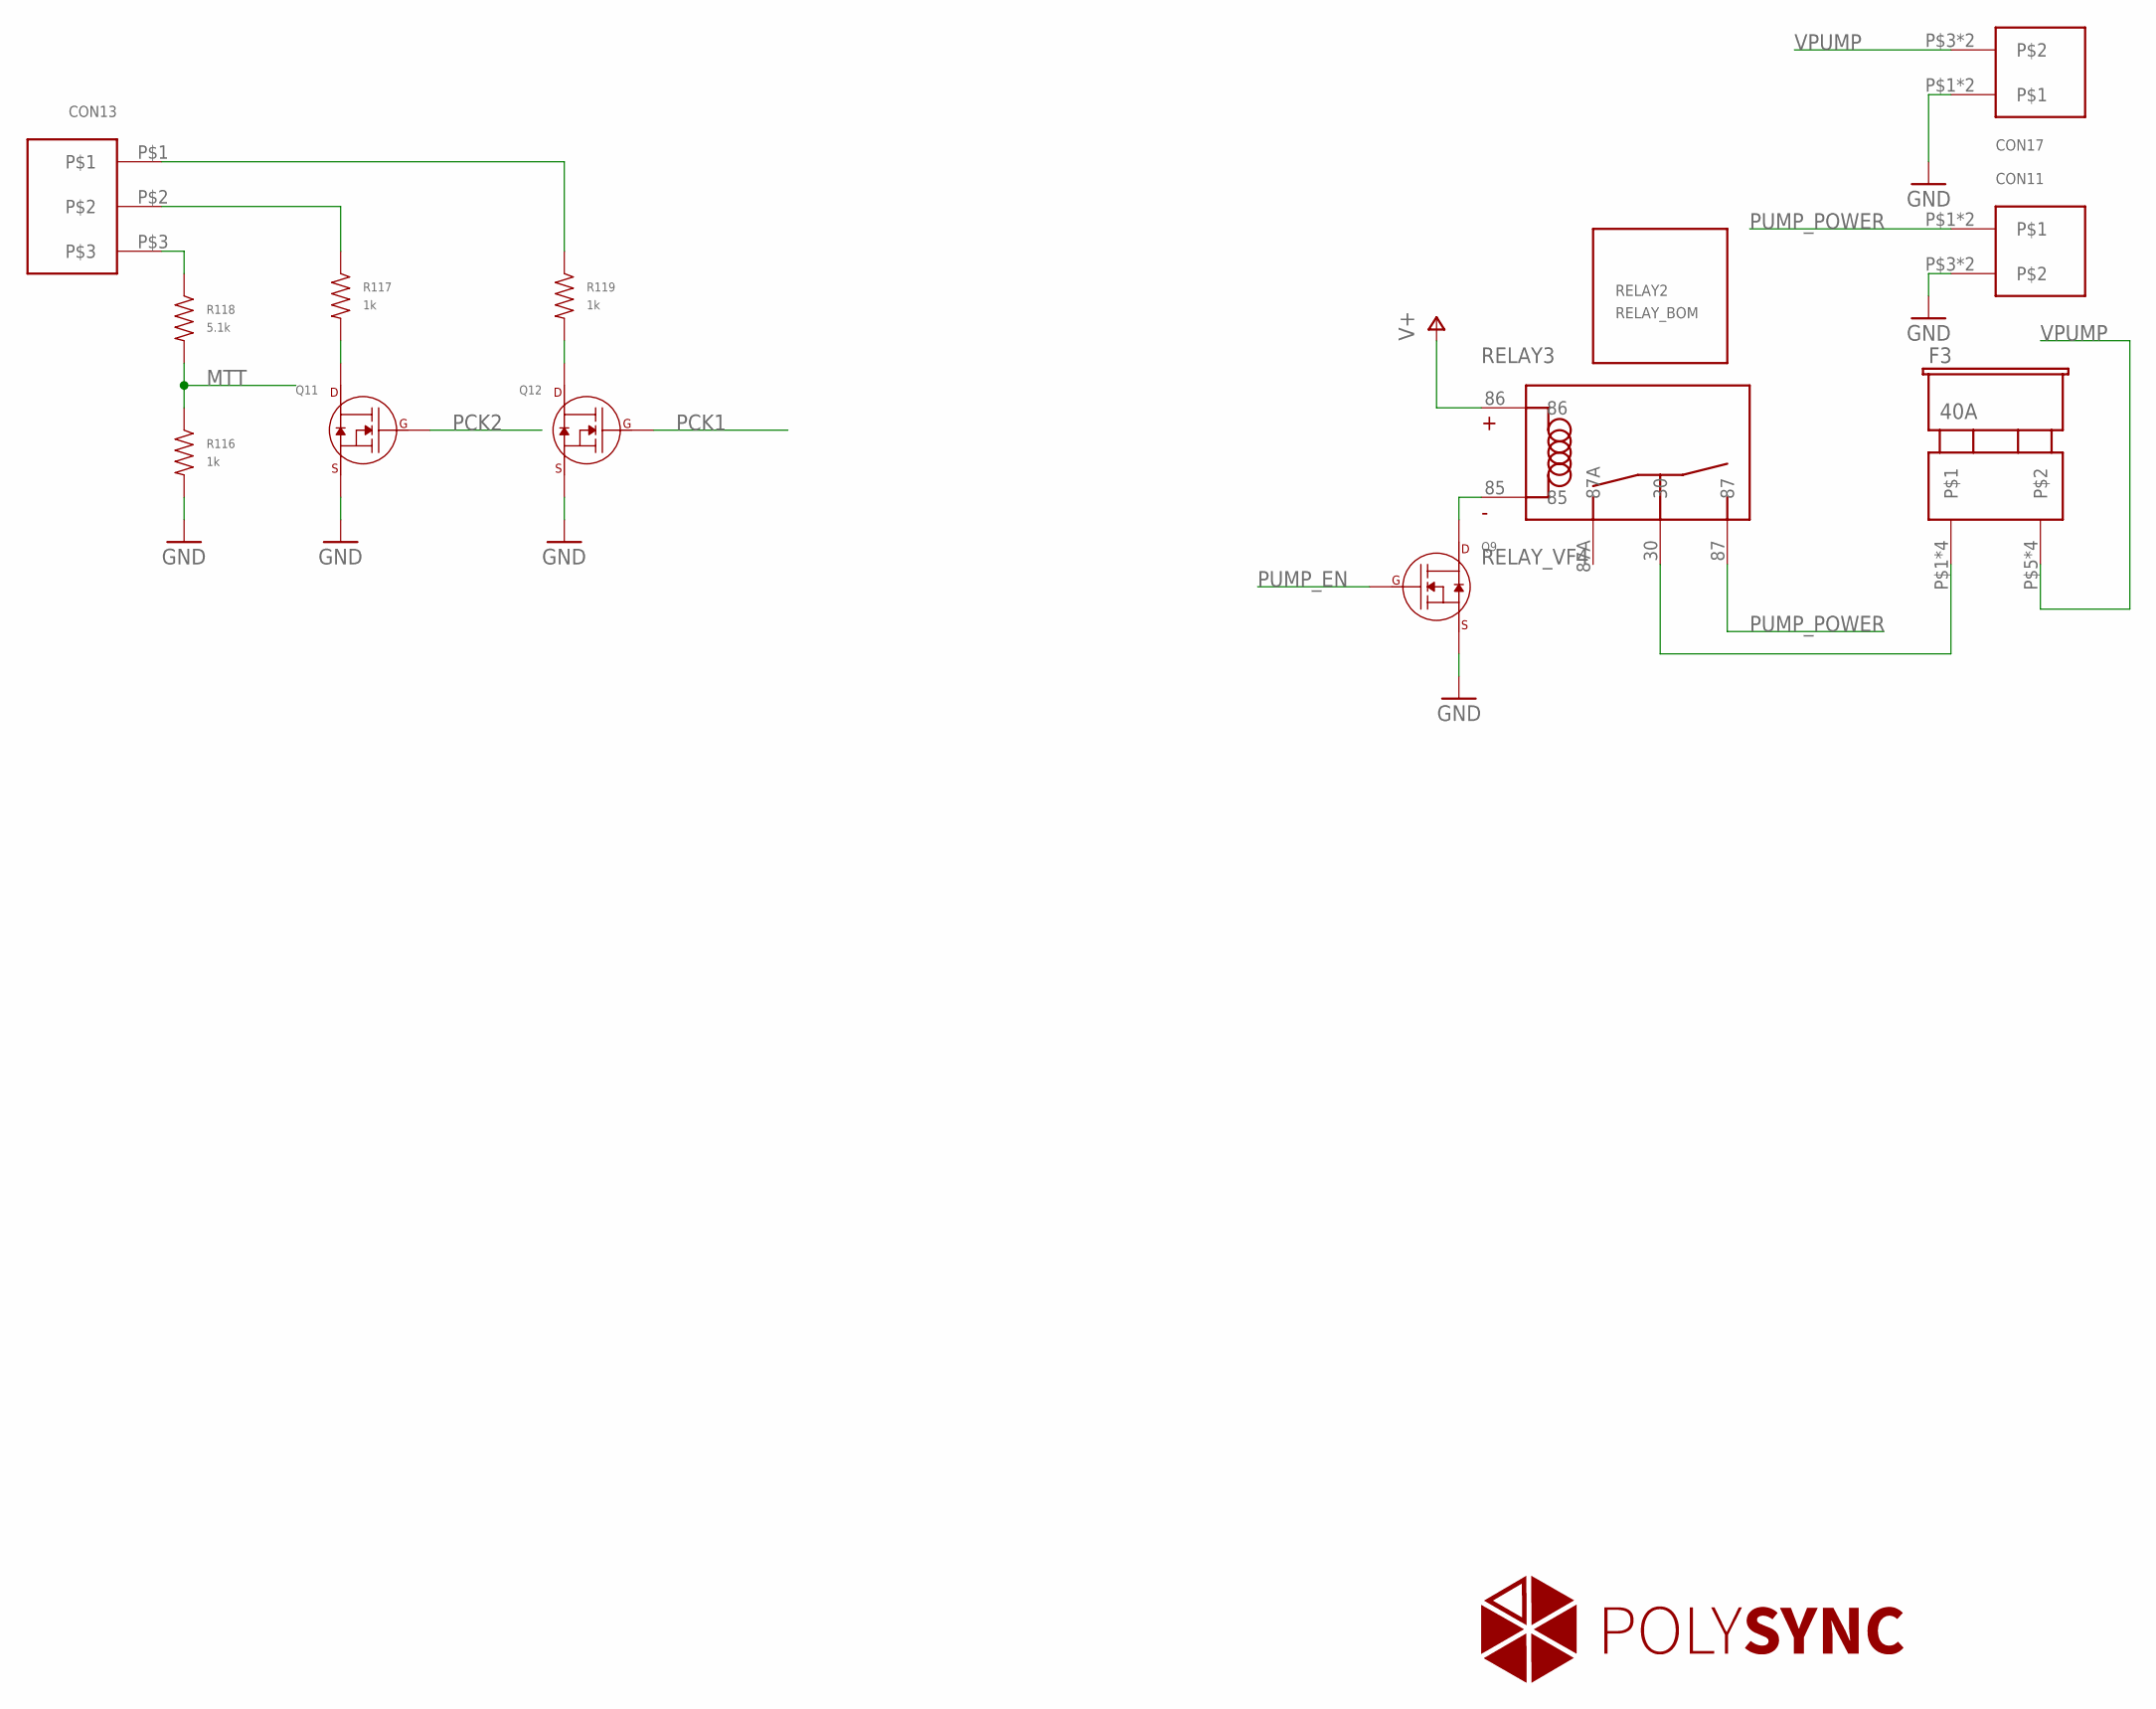
[picture p28: schematic actuator_control_1.2.0.sch, sheet 6, Actuator Test]

Parts:
CON11, CON17: CON210.16MM; PHOENIX_2_10.16MM; PARTNO 1773976
CON13: CON3; PHOENIX_3_45
F3: 40A; FUSE_ATO; PARTNO 178.6165.0001
Q9, Q11, Q12: N-CHANNEL_FET_SOT-23-3; SOT-23-3
R116, R117, R119: 1k; R0402
R118: 5.1k; R0402
RELAY2: RELAY_BOM; VCF4_RELAY; PARTNO 1432868-1
RELAY3: RELAY_VF4; VCF4-SOCKET; PARTNO VCF4-1000

Connections:
GND: CON11.P$3, CON11.P$4, CON17.P$1, CON17.P$2, Q9.P$2 (SOURCE), Q11.P$2 (SOURCE), Q12.P$2 (SOURCE), R116.P$2; also elsewhere on the board
MTT: R116.P$1, R118.P$2; also elsewhere on the board
unnamed: F3.P$1, F3.P$2, F3.P$3, F3.P$4, RELAY3.30
unnamed: Q9.P$3 (DRAIN), RELAY3.85
unnamed: CON13.P$3, R118.P$1
unnamed: CON13.P$2, R117.P$1
unnamed: CON13.P$1, R119.P$1
unnamed: Q11.P$3 (DRAIN), R117.P$2
unnamed: Q12.P$3 (DRAIN), R119.P$2
PCK1: Q12.P$1 (GATE); also elsewhere on the board
PCK2: Q11.P$1 (GATE); also elsewhere on the board
PUMP_EN: Q9.P$1 (GATE); also elsewhere on the board
PUMP_POWER: CON11.P$1, CON11.P$2, RELAY3.87
V+: RELAY3.86; also elsewhere on the board
VPUMP: CON17.P$3, CON17.P$4, F3.P$5, F3.P$6, F3.P$7, F3.P$8

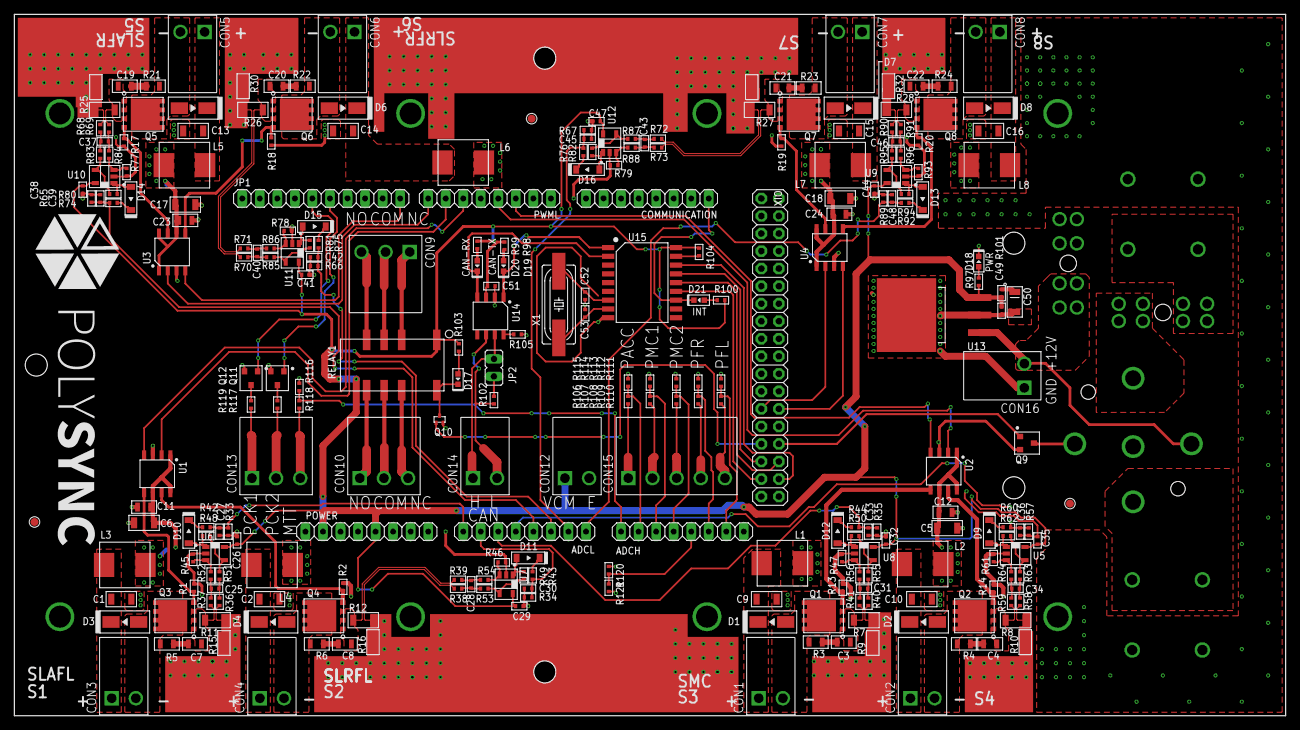
[picture p29: board actuator_control_1.2.0.brd from above]

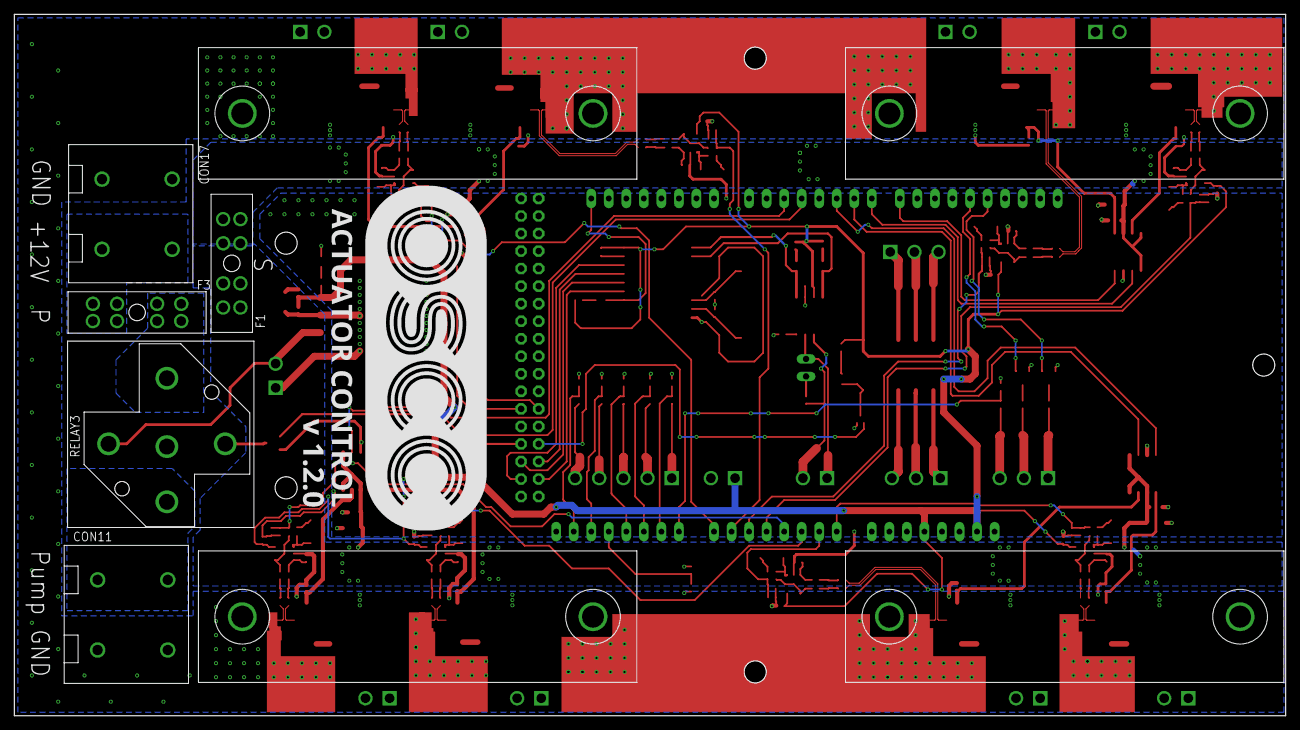
[picture p30: board actuator_control_1.2.0.brd from below]

Board: 2 copper layers, 184.2 x 101.6 mm, 270 parts (11 on the bottom side), 168 nets.

Other parts of the board:
U$3, U$7, U$9, U$10: HEATSINK_2X_75
U$11: POLYSYNC_ACT_1_2_0
U$13: POLYSYNC
