WATonomous/interfacing-mono/DBW-boards/sensor_interface/sensor_interface_1.1.0.brd

## EAGLE design DBW-boards/sensor_interface/sensor_interface_1.1.0.brd (2024-09-14)

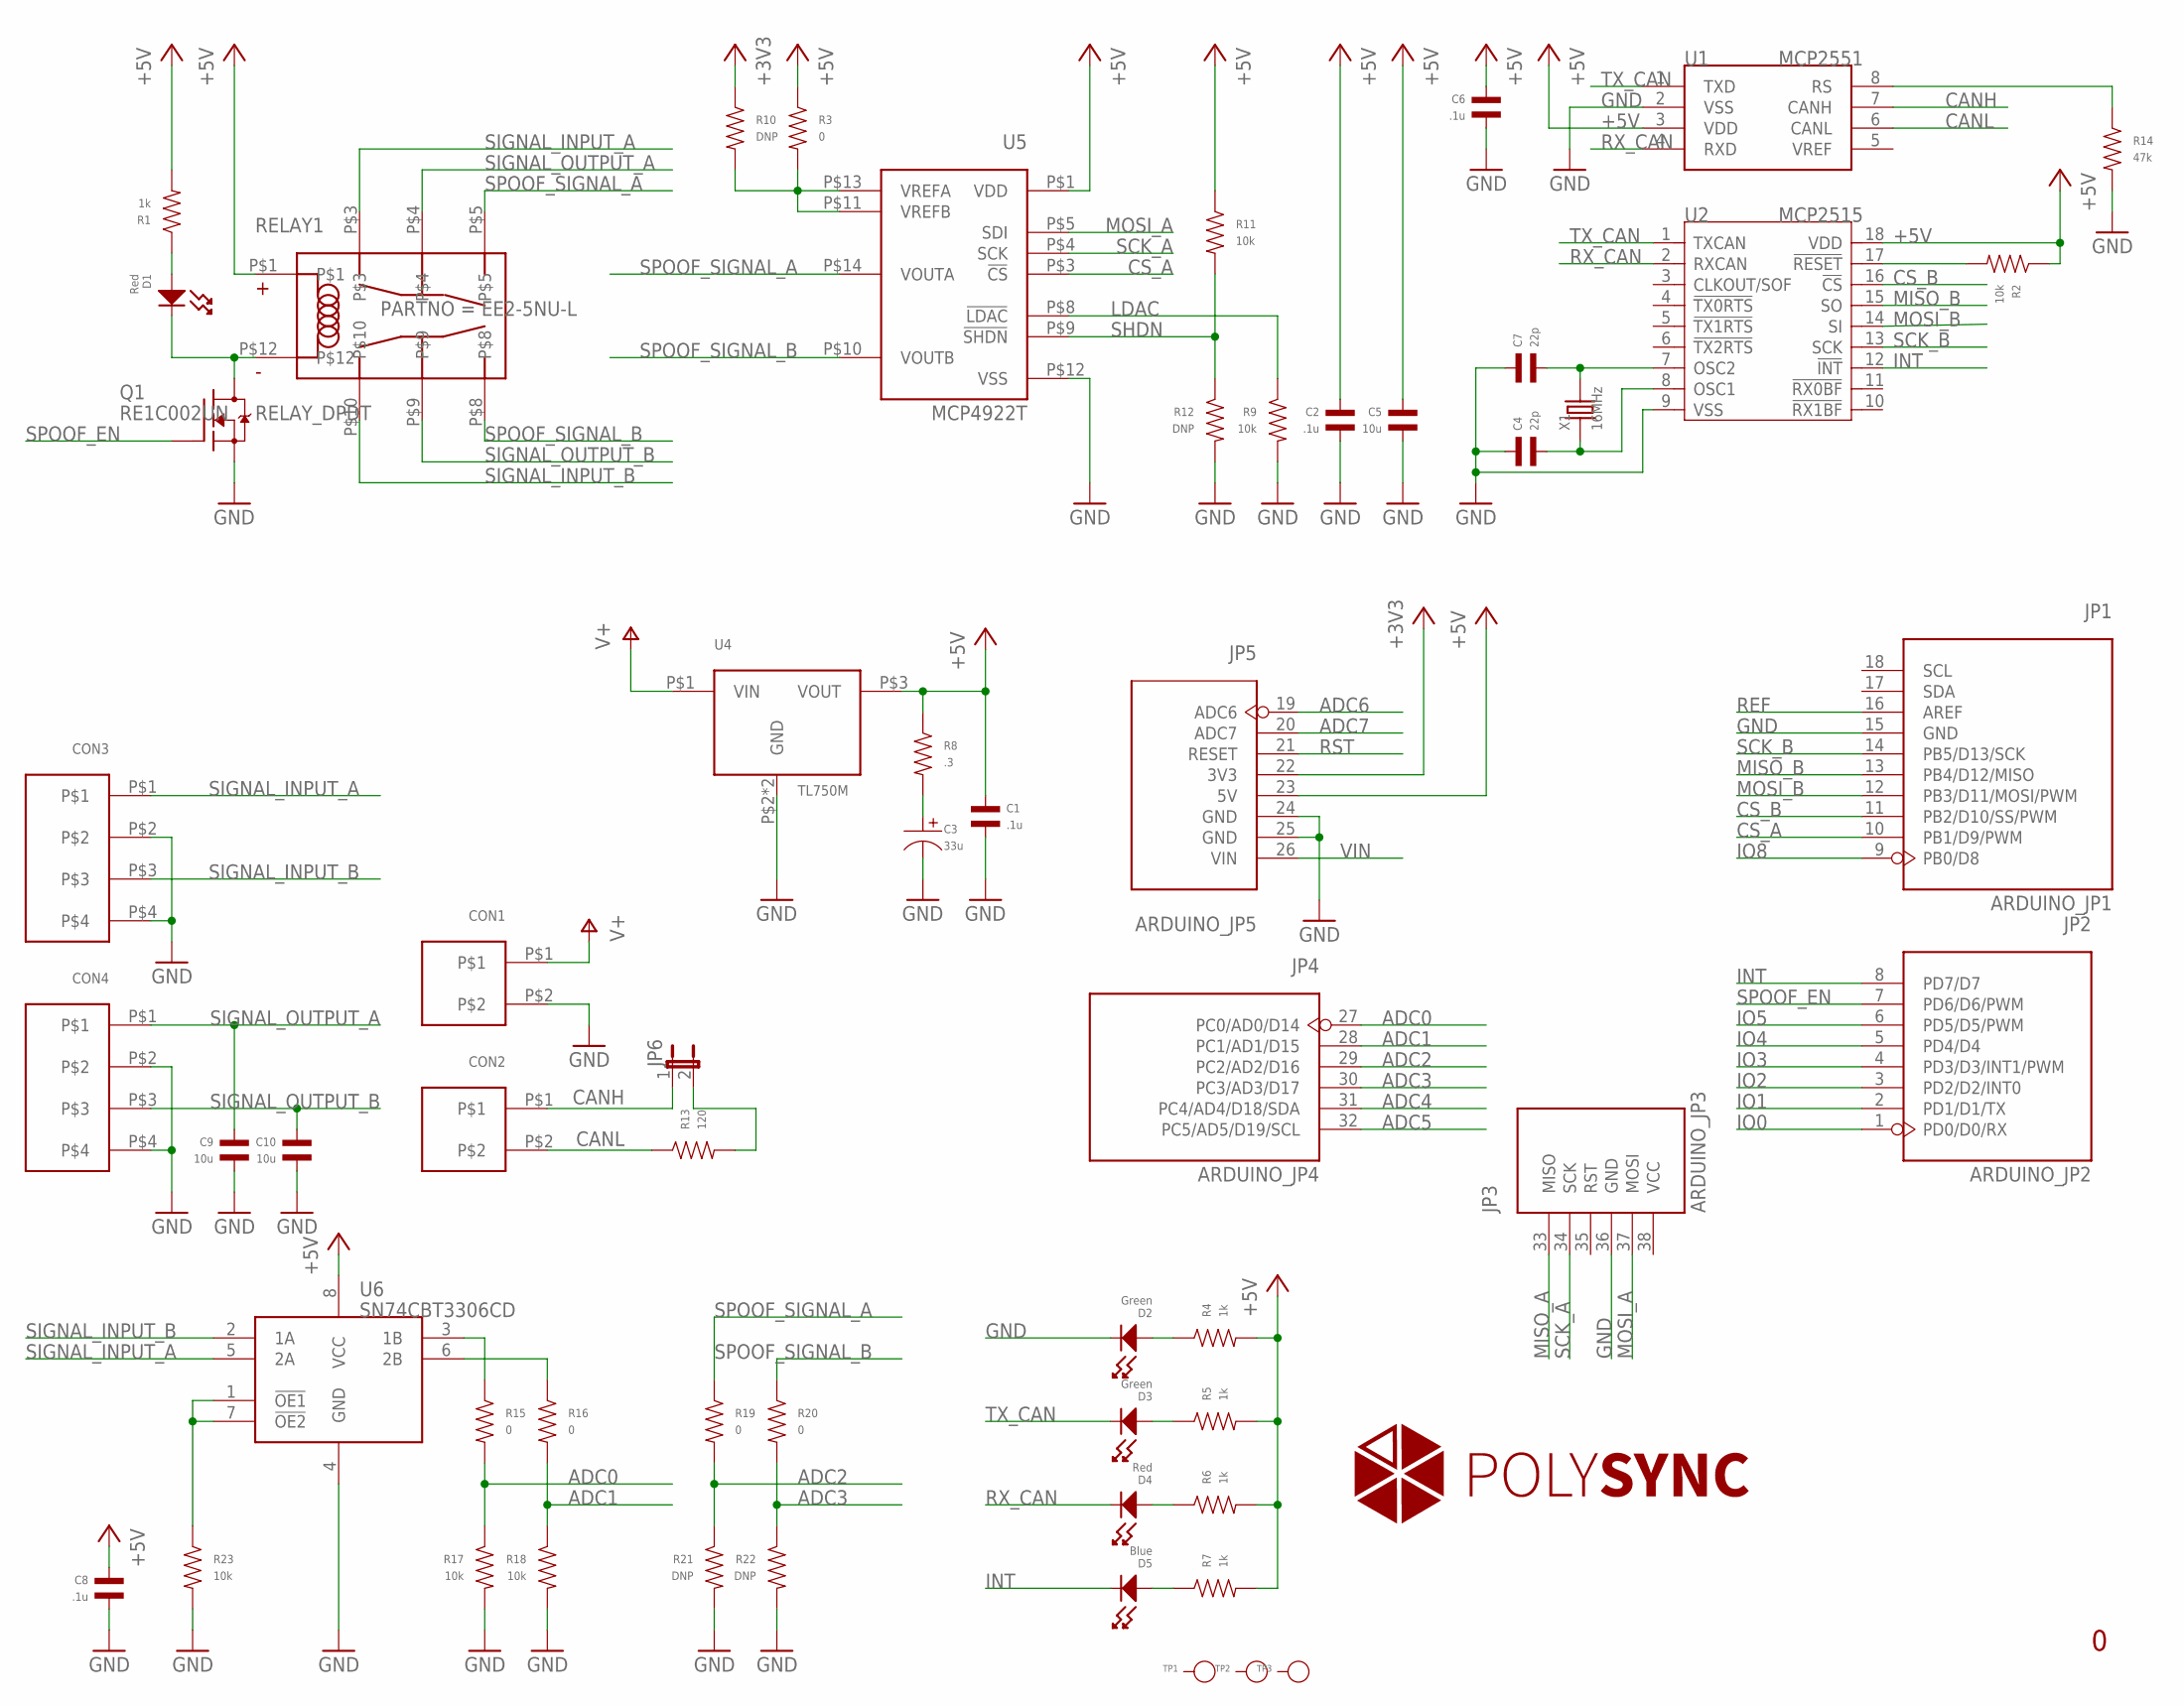
[picture p31: schematic sensor_interface_1.1.0.sch]

Parts:
C1, C2, C6, C8: .1u; C0402
C3: 33u; CP1206
C4, C7: 22p; C0402
C5, C9, C10: 10u; C0805
CON1, CON2: CON23.5MM; PHOENIX_2_45
CON3, CON4: CON4; PHOENIX_4_45
D1, D4: Red; LED0603
D2, D3: Green; LED0603
D5: Blue; LED0603
JP1: ARDUINO_JP1
JP2: ARDUINO_JP2
JP3: ARDUINO_JP3
JP4: ARDUINO_JP4
JP5: ARDUINO_JP5
JP6: JP1E; JP1
Q1: RE1C002UN; EMT3F
R1, R4, R5, R6, R7: 1k; R0402
R2, R9, R11, R17, R18, R23: 10k; R0402
R3, R15, R16, R19, R20: 0; R0402
R8: .3; R0402
R10, R12, R21, R22: DNP; R0402
R13: 120; R0402
R14: 47k; R0402
RELAY1: RELAY_DPDT; KEMET_EE2; PARTNO EE2-5NU-L
TP1, TP2, TP3: PAD-TEST-POINT'4545'; TP_4545
U1: MCP2551; SOIC8-6.0
U2: MCP2515; SOIC18
U4: TL750M; TO-263
U5: MCP4922T; TSSOP-14
U6: SN74CBT3306CD; SOIC-8
X1: 16MHz; HC49UP

Connections:
+3V3: JP5.22 (3V3), R10.P$1
+5V: C1.P$1, C2.P$1, C5.P$1, C6.P$1, C8.P$1, JP5.23 (5V), R1.P$2, R2.P$1, R3.P$1, R4.P$2, R5.P$2, R6.P$2, R7.P$2, R8.P$1, R11.P$1, RELAY1.P$1, U1.3 (VDD), U2.18 (VDD), U4.P$3 (VOUT), U5.P$1 (VDD), U6.8 (VCC)
ADC0: JP4.27 (PC0/AD0/D14), R15.P$2, R17.P$1
ADC1: JP4.28 (PC1/AD1/D15), R16.P$2, R18.P$1
ADC2: JP4.29 (PC2/AD2/D16), R19.P$2, R21.P$1
ADC3: JP4.30 (PC3/AD3/D17), R20.P$2, R22.P$1
ADC4: JP4.31 (PC4/AD4/D18/SDA)
ADC5: JP4.32 (PC5/AD5/D19/SCL)
ADC6: JP5.19 (ADC6)
ADC7: JP5.20 (ADC7)
CANH: CON2.P$1, JP6.1, U1.7 (CANH)
CANL: CON2.P$2, R13.P$1, U1.6 (CANL)
CS_A: JP1.10 (PB1/D9/PWM), U5.P$3 (!CS)
CS_B: JP1.11 (PB2/D10/SS/PWM), U2.16 (!CS)
GND: C1.P$2, C2.P$2, C3.P$2, C4.P$1, C5.P$2, C6.P$2, C7.P$1, C8.P$2, C9.P$2, C10.P$2, CON1.P$2, CON3.P$2, CON3.P$4, CON4.P$2, CON4.P$4, D2.CATHODE, JP1.15 (GND), JP3.36 (GND), JP5.24 (GND), JP5.25 (GND), Q1.P$2 (S), R9.P$2, R12.P$2, R14.P$2, R17.P$2, R18.P$2, R21.P$2, R22.P$2, R23.P$2, U1.2 (VSS), U2.9 (VSS), U4.P$2 (GND), U4.P$4 (GND), U5.P$12 (VSS), U6.4 (GND)
INT: D5.CATHODE, JP2.8 (PD7/D7), U2.12 (!INT)
IO0: JP2.1 (PD0/D0/RX)
IO1: JP2.2 (PD1/D1/TX)
IO2: JP2.3 (PD2/D2/INT0)
IO3: JP2.4 (PD3/D3/INT1/PWM)
IO4: JP2.5 (PD4/D4)
IO5: JP2.6 (PD5/D5/PWM)
IO8: JP1.9 (PB0/D8)
LDAC: R9.P$1, U5.P$8 (!LDAC)
MISO_A: JP3.33 (MISO)
MISO_B: JP1.13 (PB4/D12/MISO), U2.15 (SO)
MOSI_A: JP3.37 (MOSI), U5.P$5 (SDI)
MOSI_B: JP1.12 (PB3/D11/MOSI/PWM), U2.14 (SI)
unnamed: D3.ANODE, R5.P$1
unnamed: JP6.2, R13.P$2
unnamed: D1.CATHODE, Q1.P$3 (D), RELAY1.P$12
unnamed: C3.P$1, R8.P$2
unnamed: D4.ANODE, R6.P$1
unnamed: D2.ANODE, R4.P$1
unnamed: R3.P$2, R10.P$2, U5.P$11 (VREFB), U5.P$13 (VREFA)
unnamed: D5.ANODE, R7.P$1
unnamed: R14.P$1, U1.8 (RS)
unnamed: D1.ANODE, R1.P$1
unnamed: R23.P$1, U6.1 (!OE1), U6.7 (!OE2)
unnamed: R16.P$1, U6.6 (2B)
unnamed: R15.P$1, U6.3 (1B)
unnamed: C7.P$2, U2.7 (OSC2), X1.2
unnamed: C4.P$2, U2.8 (OSC1), X1.1
REF: JP1.16 (AREF)
RST: JP5.21 (RESET)
RST_N: R2.P$2, U2.17 (!RESET)
RX_CAN: D4.CATHODE, U1.4 (RXD), U2.2 (RXCAN)
SCK_A: JP3.34 (SCK), U5.P$4 (SCK)
SCK_B: JP1.14 (PB5/D13/SCK), U2.13 (SCK)
SHDN: R11.P$2, R12.P$1, U5.P$9 (!SHDN)
SIGNAL_INPUT_A: CON3.P$1, RELAY1.P$3, U6.5 (2A)
SIGNAL_INPUT_B: CON3.P$3, RELAY1.P$10, U6.2 (1A)
SIGNAL_OUTPUT_A: C9.P$1, CON4.P$1, RELAY1.P$4
SIGNAL_OUTPUT_B: C10.P$1, CON4.P$3, RELAY1.P$9
SPOOF_EN: JP2.7 (PD6/D6/PWM), Q1.P$1 (G)
SPOOF_SIGNAL_A: R19.P$1, RELAY1.P$5, U5.P$14 (VOUTA)
SPOOF_SIGNAL_B: R20.P$1, RELAY1.P$8, U5.P$10 (VOUTB)
TX_CAN: D3.CATHODE, U1.1 (TXD), U2.1 (TXCAN)
V+: CON1.P$1, U4.P$1 (VIN)
VIN: JP5.26 (VIN)

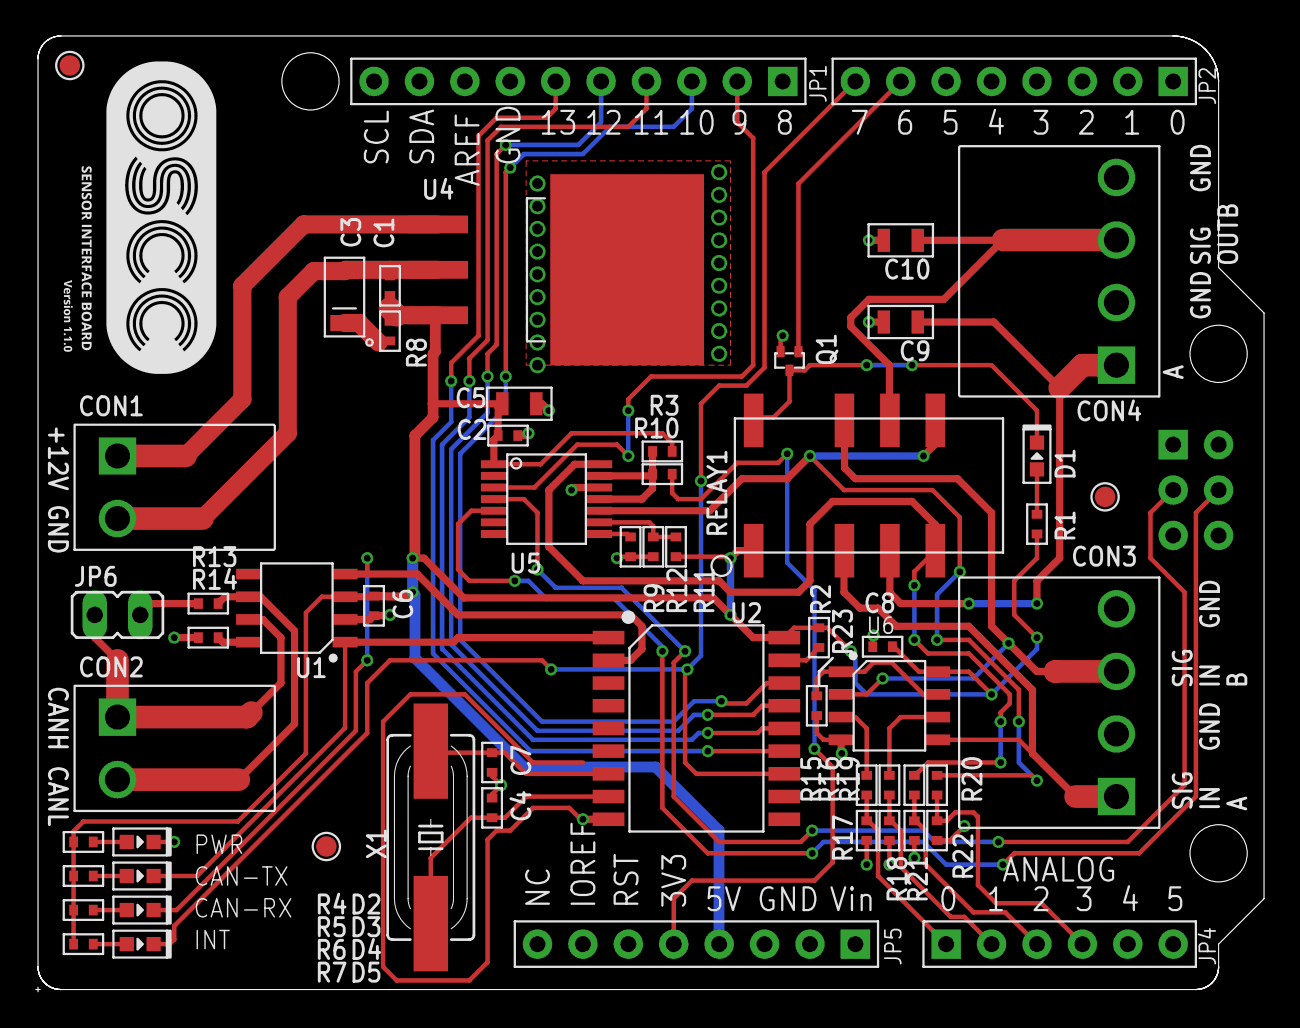
[picture p32: board sensor_interface_1.1.0.brd from above]

Board: 2 copper layers, 68.6 x 53.3 mm, 61 parts (0 on the bottom side), 45 nets.

Other parts of the board:
U$1: POLYSYNC_STEERING_BOT
U$2: POLYSYNC_SENSOR_1_1_0
