WATonomous/interfacing-mono/DBW-boards/gateway/gateway_r0.brd

## EAGLE design DBW-boards/gateway/gateway_r0.brd (2024-09-14)

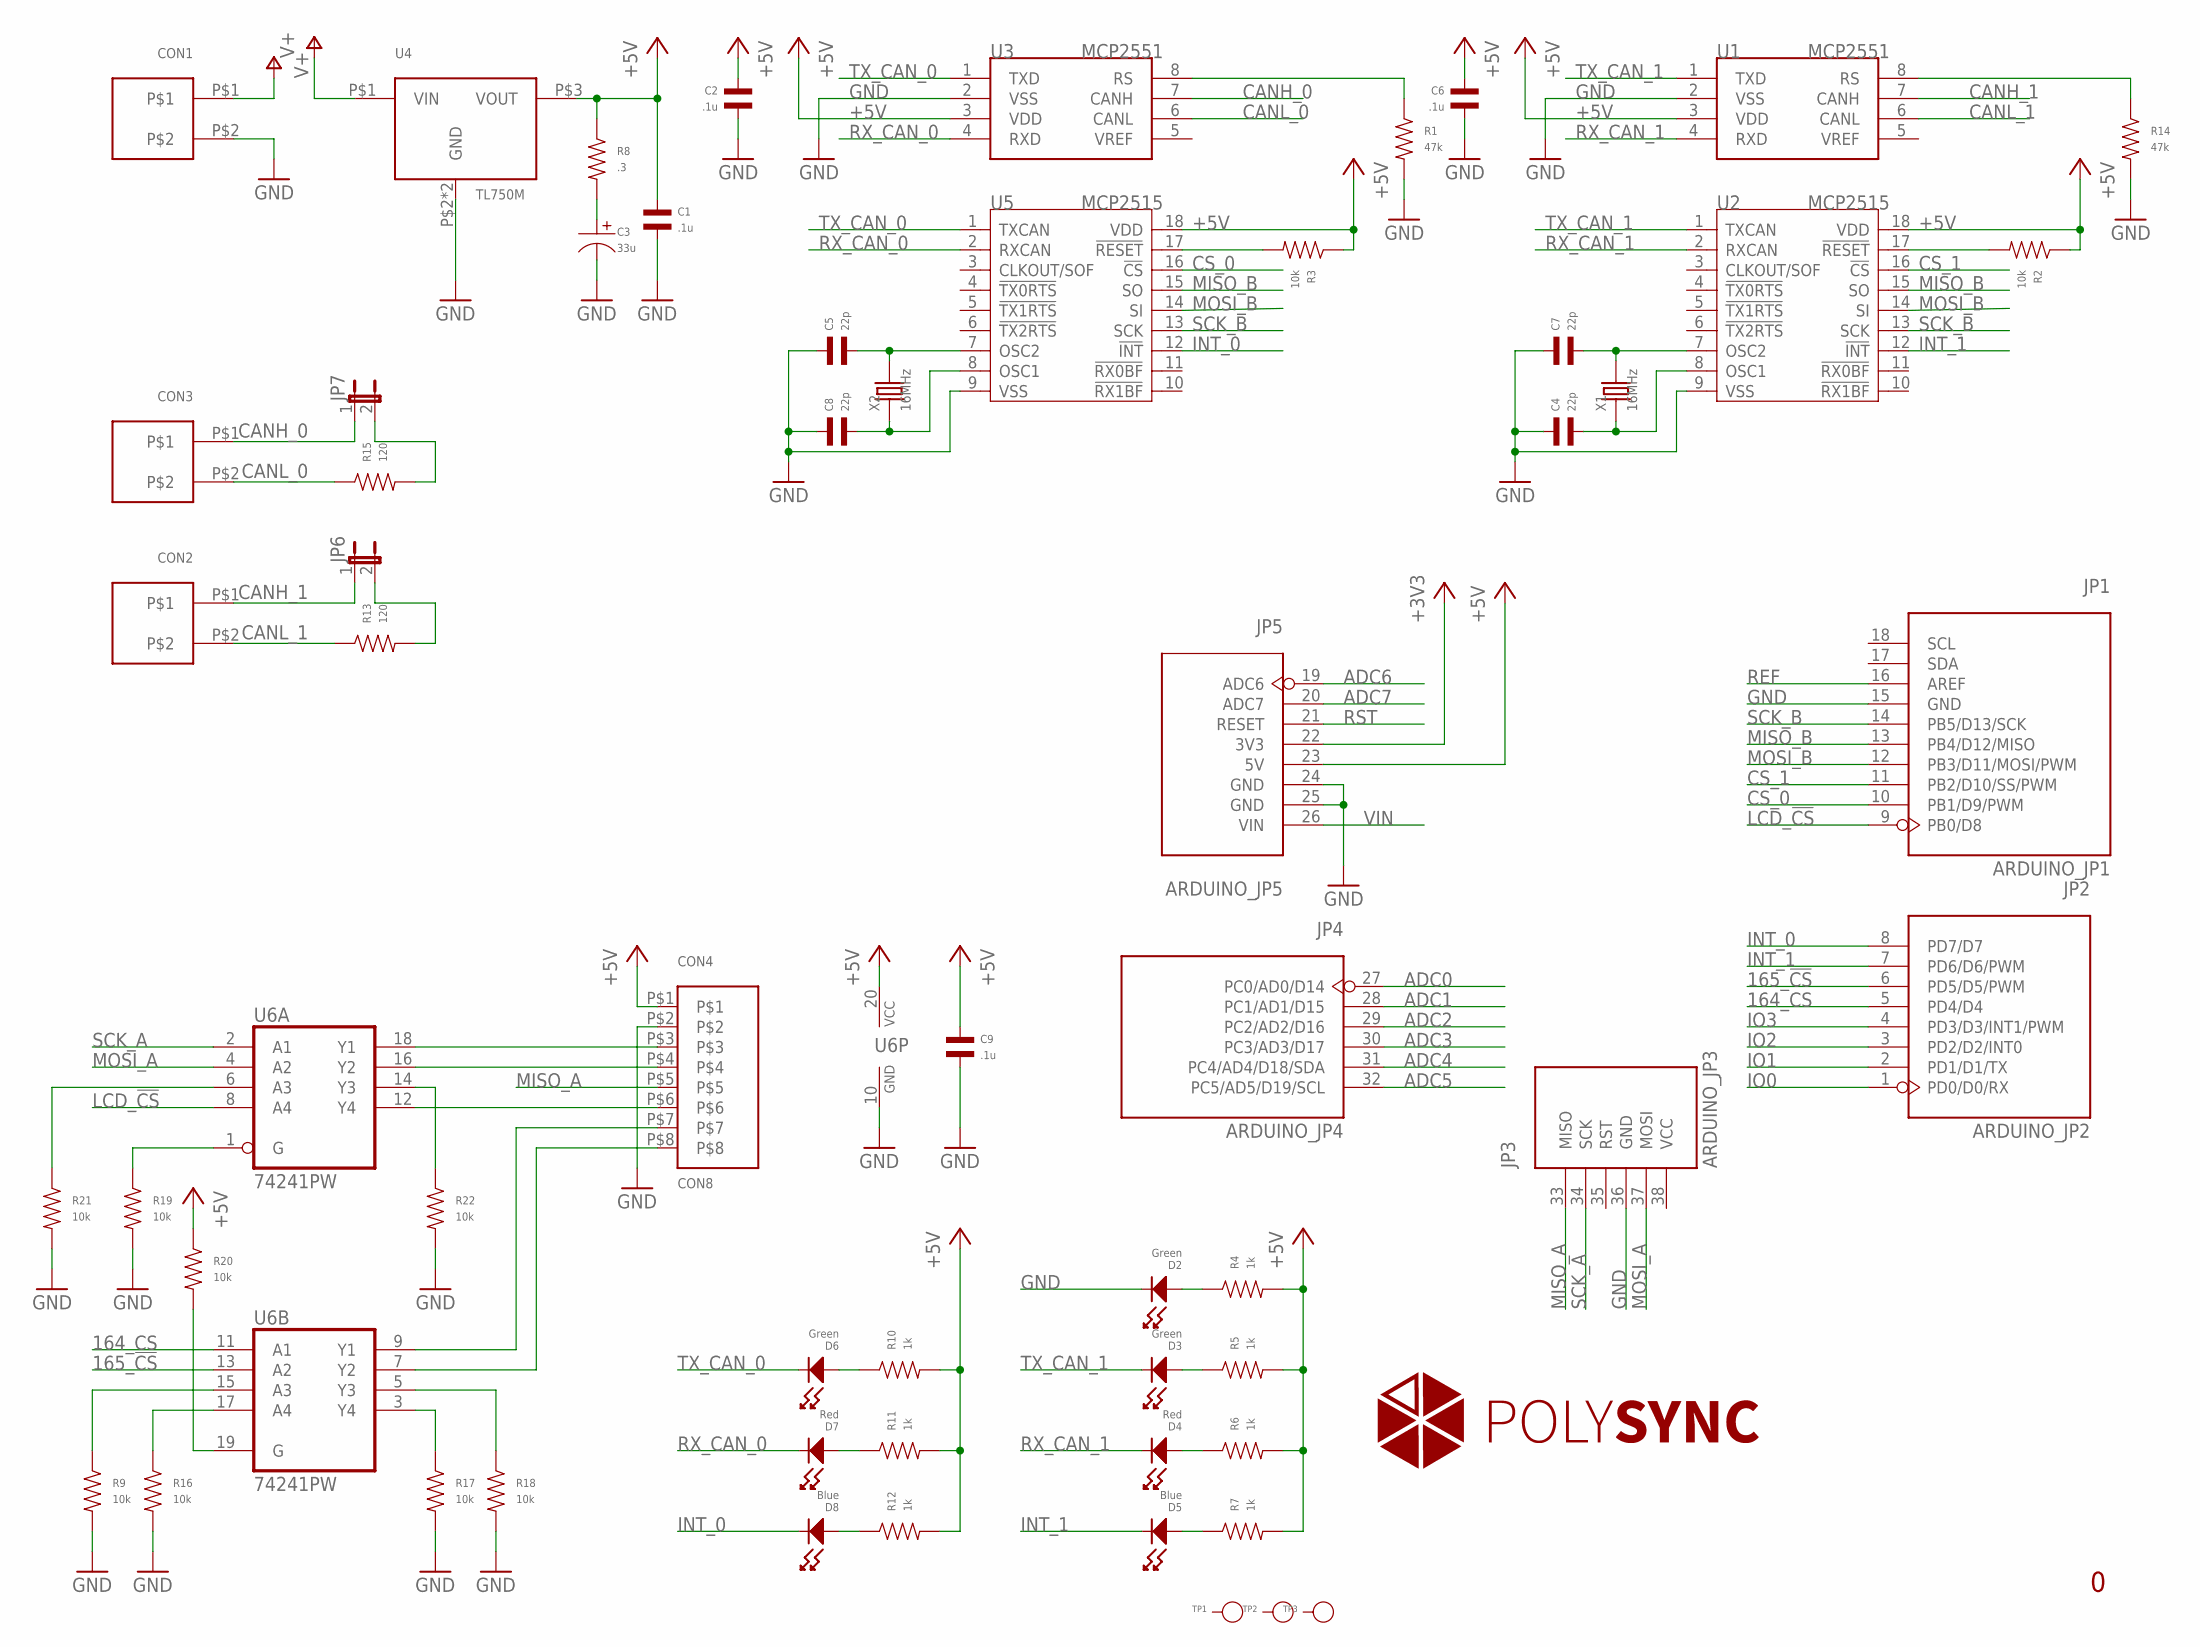
[picture p33: schematic gateway_r0.sch]

Parts:
C1, C2, C6, C9: .1u; C0402
C3: 33u; CP1206
C4, C5, C7, C8: 22p; C0402
CON1, CON2, CON3: CON23.5MM; PHOENIX_2_45
CON4: CON8; PH-8-SM
D2, D3, D6: Green; LED0603
D4, D7: Red; LED0603
D5, D8: Blue; LED0603
JP1: ARDUINO_JP1
JP2: ARDUINO_JP2
JP3: ARDUINO_JP3
JP4: ARDUINO_JP4
JP5: ARDUINO_JP5
JP6, JP7: JP1E; JP1
R1, R14: 47k; R0402
R2, R3, R9, R16, R17, R18, R19, R20, R21, R22: 10k; R0402
R4, R5, R6, R7, R10, R11, R12: 1k; R0402
R8: .3; R0402
R13, R15: 120; R0402
TP1, TP2, TP3: PAD-TEST-POINT'4545'; TP_4545
U1, U3: MCP2551; SOIC8-6.0
U2, U5: MCP2515; SOIC18
U4: TL750M; TO-263
U6: 74241PW; PW_R-PDSO-G20
X1, X2: 16MHz; HC49UP

Connections:
164_CS: JP2.5 (PD4/D4), U6.11 (A1)
165_!CS: JP2.6 (PD5/D5/PWM), U6.13 (A2)
+3V3: JP5.22 (3V3)
+5V: C1.P$1, C2.P$1, C6.P$1, C9.P$1, CON4.P$1, JP5.23 (5V), R2.P$1, R3.P$1, R4.P$2, R5.P$2, R6.P$2, R7.P$2, R8.P$1, R10.P$2, R11.P$2, R12.P$2, R20.P$1, U1.3 (VDD), U2.18 (VDD), U3.3 (VDD), U4.P$3 (VOUT), U5.18 (VDD), U6.20 (VCC)
ADC0: JP4.27 (PC0/AD0/D14)
ADC1: JP4.28 (PC1/AD1/D15)
ADC2: JP4.29 (PC2/AD2/D16)
ADC3: JP4.30 (PC3/AD3/D17)
ADC4: JP4.31 (PC4/AD4/D18/SDA)
ADC5: JP4.32 (PC5/AD5/D19/SCL)
ADC6: JP5.19 (ADC6)
ADC7: JP5.20 (ADC7)
CANH_0: CON3.P$1, JP7.1, U3.7 (CANH)
CANH_1: CON2.P$1, JP6.1, U1.7 (CANH)
CANL_0: CON3.P$2, R15.P$1, U3.6 (CANL)
CANL_1: CON2.P$2, R13.P$1, U1.6 (CANL)
CS_0: JP1.10 (PB1/D9/PWM), U5.16 (!CS)
CS_1: JP1.11 (PB2/D10/SS/PWM), U2.16 (!CS)
GND: C1.P$2, C2.P$2, C3.P$2, C4.P$1, C5.P$1, C6.P$2, C7.P$1, C8.P$1, C9.P$2, CON1.P$2, CON4.P$2, D2.CATHODE, JP1.15 (GND), JP3.36 (GND), JP5.24 (GND), JP5.25 (GND), R1.P$2, R9.P$2, R14.P$2, R16.P$2, R17.P$2, R18.P$2, R19.P$2, R21.P$2, R22.P$2, U1.2 (VSS), U2.9 (VSS), U3.2 (VSS), U4.P$2 (GND), U4.P$4 (GND), U5.9 (VSS), U6.10 (GND)
INT_0: D8.CATHODE, JP2.8 (PD7/D7), U5.12 (!INT)
INT_1: D5.CATHODE, JP2.7 (PD6/D6/PWM), U2.12 (!INT)
IO0: JP2.1 (PD0/D0/RX)
IO1: JP2.2 (PD1/D1/TX)
IO2: JP2.3 (PD2/D2/INT0)
IO3: JP2.4 (PD3/D3/INT1/PWM)
LCD_!CS: JP1.9 (PB0/D8), U6.8 (A4)
MISO_A: CON4.P$5, JP3.33 (MISO)
MISO_B: JP1.13 (PB4/D12/MISO), U2.15 (SO), U5.15 (SO)
MOSI_A: JP3.37 (MOSI), U6.4 (A2)
MOSI_B: JP1.12 (PB3/D11/MOSI/PWM), U2.14 (SI), U5.14 (SI)
unnamed: D3.ANODE, R5.P$1
unnamed: JP6.2, R13.P$2
unnamed: C5.P$2, U5.7 (OSC2), X2.2
unnamed: C3.P$1, R8.P$2
unnamed: D4.ANODE, R6.P$1
unnamed: D2.ANODE, R4.P$1
unnamed: C8.P$2, U5.8 (OSC1), X2.1
unnamed: D5.ANODE, R7.P$1
unnamed: R14.P$1, U1.8 (RS)
unnamed: R1.P$1, U3.8 (RS)
unnamed: CON4.P$3, U6.18 (Y1)
unnamed: D6.ANODE, R10.P$1
unnamed: D7.ANODE, R11.P$1
unnamed: D8.ANODE, R12.P$1
unnamed: JP7.2, R15.P$2
unnamed: C7.P$2, U2.7 (OSC2), X1.2
unnamed: C4.P$2, U2.8 (OSC1), X1.1
unnamed: CON4.P$4, U6.16 (Y2)
unnamed: R21.P$1, U6.6 (A3)
unnamed: CON4.P$6, U6.12 (Y4)
unnamed: CON4.P$7, U6.9 (Y1)
unnamed: CON4.P$8, U6.7 (Y2)
unnamed: R9.P$1, U6.15 (A3)
unnamed: R16.P$1, U6.17 (A4)
unnamed: R17.P$1, U6.3 (Y4)
unnamed: R18.P$1, U6.5 (Y3)
unnamed: R19.P$1, U6.1 (G)
unnamed: R20.P$2, U6.19 (G)
unnamed: R22.P$1, U6.14 (Y3)
REF: JP1.16 (AREF)
RST: JP5.21 (RESET)
RST_N: R2.P$2, U2.17 (!RESET)
RST_N1: R3.P$2, U5.17 (!RESET)
RX_CAN_0: D7.CATHODE, U3.4 (RXD), U5.2 (RXCAN)
RX_CAN_1: D4.CATHODE, U1.4 (RXD), U2.2 (RXCAN)
SCK_A: JP3.34 (SCK), U6.2 (A1)
SCK_B: JP1.14 (PB5/D13/SCK), U2.13 (SCK), U5.13 (SCK)
TX_CAN_0: D6.CATHODE, U3.1 (TXD), U5.1 (TXCAN)
TX_CAN_1: D3.CATHODE, U1.1 (TXD), U2.1 (TXCAN)
V+: CON1.P$1, U4.P$1 (VIN)
VIN: JP5.26 (VIN)

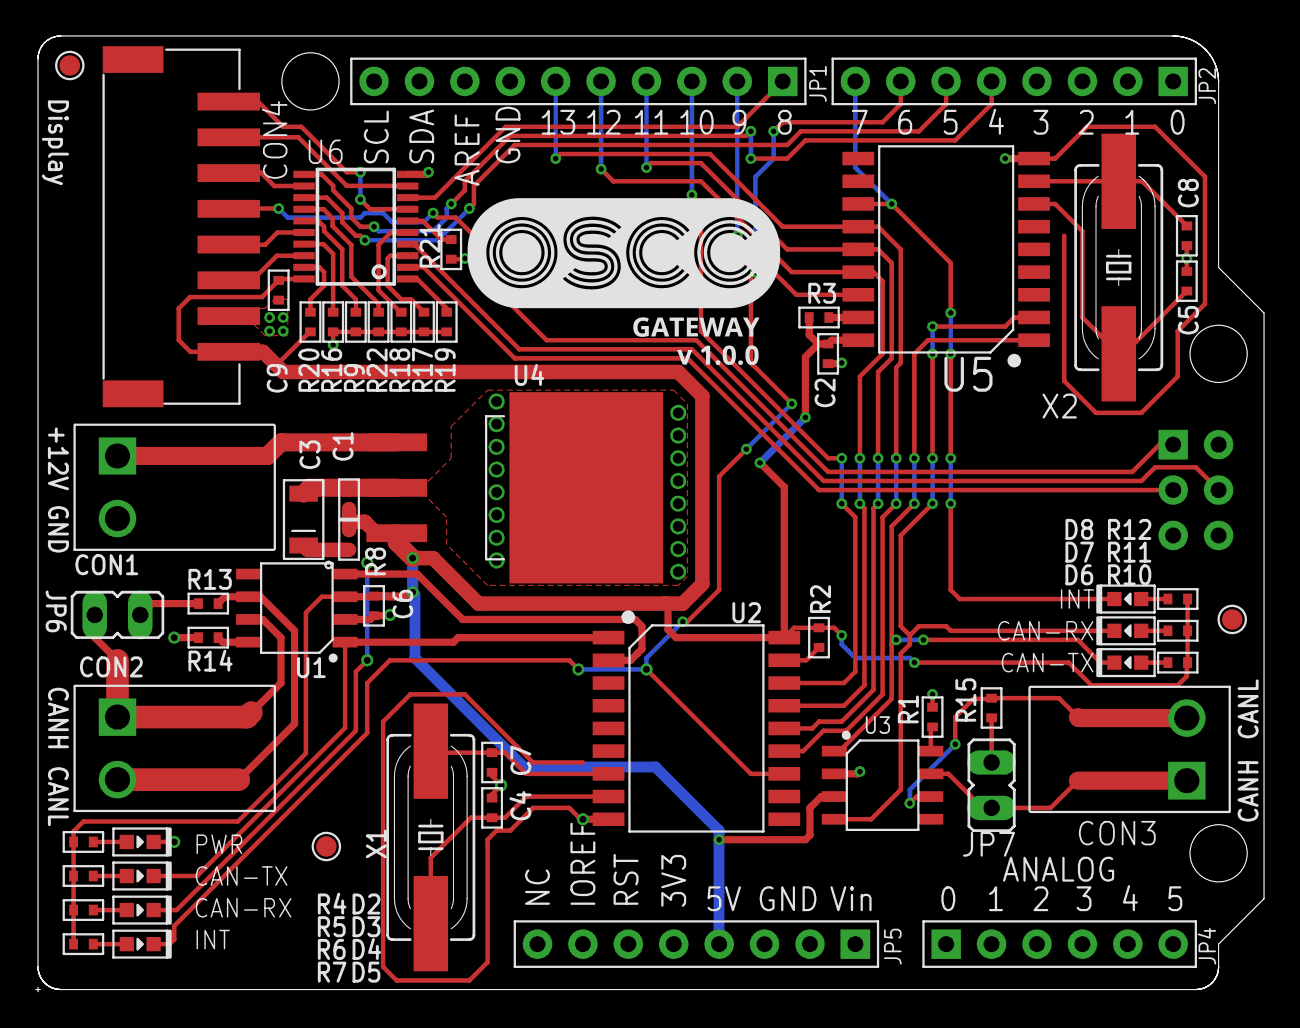
[picture p34: board gateway_r0.brd from above]

Board: 2 copper layers, 68.6 x 53.3 mm, 62 parts (0 on the bottom side), 55 nets.

Other parts of the board:
U$1: POLYSYNC_STEERING_BOT
U$2: POLYSYNC_GATEWAY_1_0_0
