WATonomous/interfacing-mono/(commit log)

2024-09-14 Added oscc-joystick-commander as part of the main repository
    [ArduinoUnoMockup.SLDPRT, CANShieldMockup.SLDPRT, EStopHousing.SLDPRT, EStopHousing.STL, STC_assembly.SLDASM, STC_housing.STL, STC_housing.sldprt, STC_lid.SLDPRT]
2024-09-16 Adding Board files, read me to mono-repo
    [actuator_control_1.2.0.brd, actuator_control_1.2.0.sch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]
